NU-Horizonsat/RT1050-Board/RT1050.step

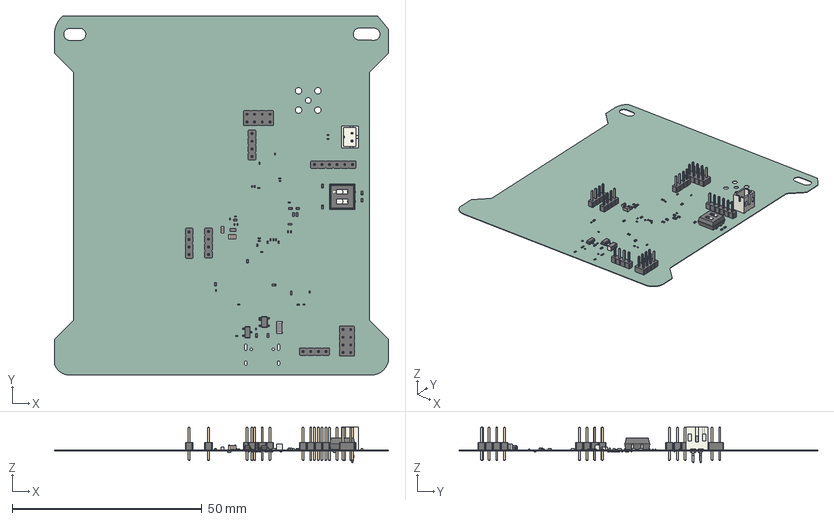
[picture p1: CAD file, 2025-01-03]
RT1050.step
88.0 x 94.5 x 9.40 mm
C_0201_0603Metric x 58
R_0402_1005Metric x 18
PinHeader_1x04_P200mm_Vertical x 4
L_0603_1608Metric
SOT_23
SOT_143
C_0805_2012Metric
PinHeader_1x06_P200mm_Vertical
PinHeader_2x04_P200mm_Vertical x 2
C_0402_1005Metric x 2
JST_B2B_PH_K
SW_DIP_SPSTx02_Slide_67x664mm_W673mm_P254mm_LowProfile_JPin
L_1206_3216Metric
C_0603_1608Metric
RT1050_PCB
