NU-Horizonsat/RT1050-Board/RT1050.pdf

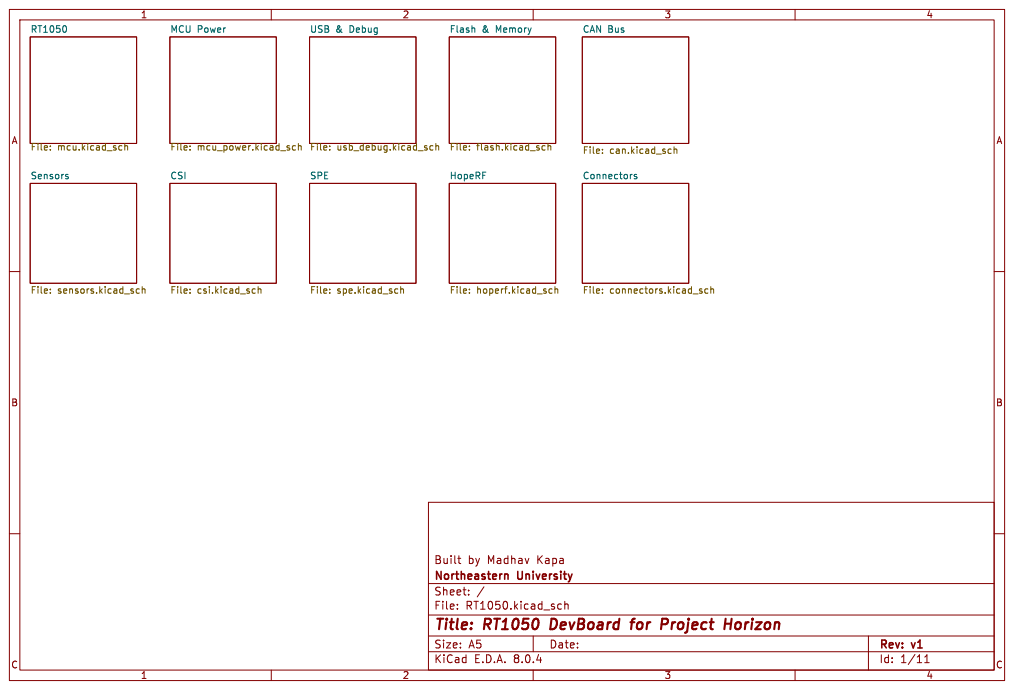
[picture p2: page 1]

Id: 1/11 Title: RT1050 DevBoard for Project Horizon

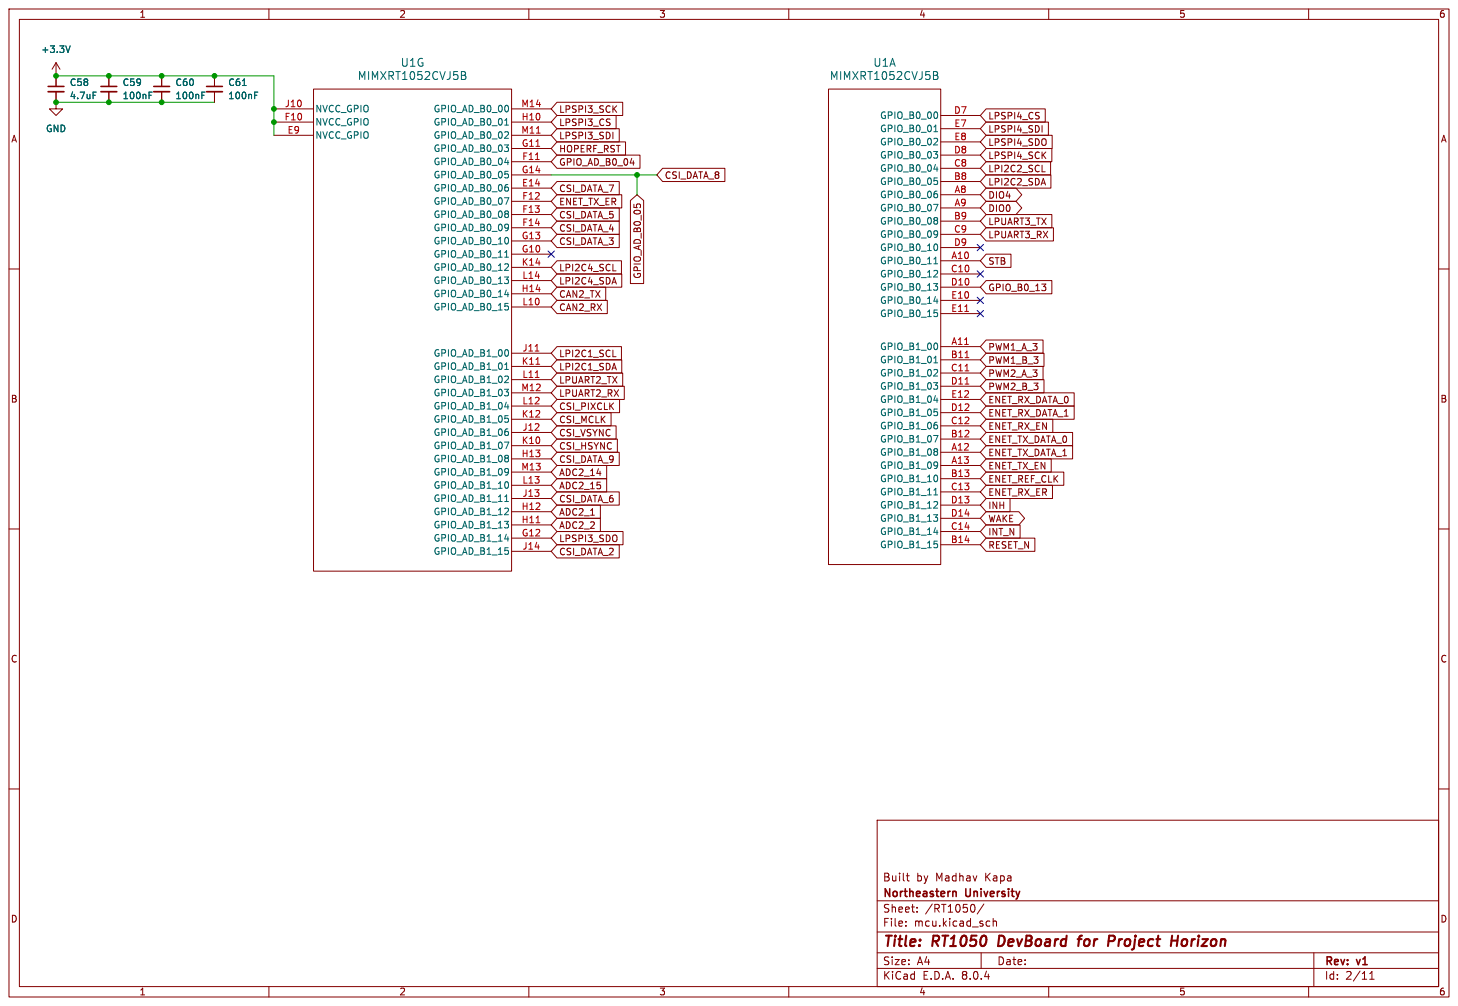
[picture p3: page 2]

Id: 2/11 Title: RT1050 DevBoard for Project Horizon

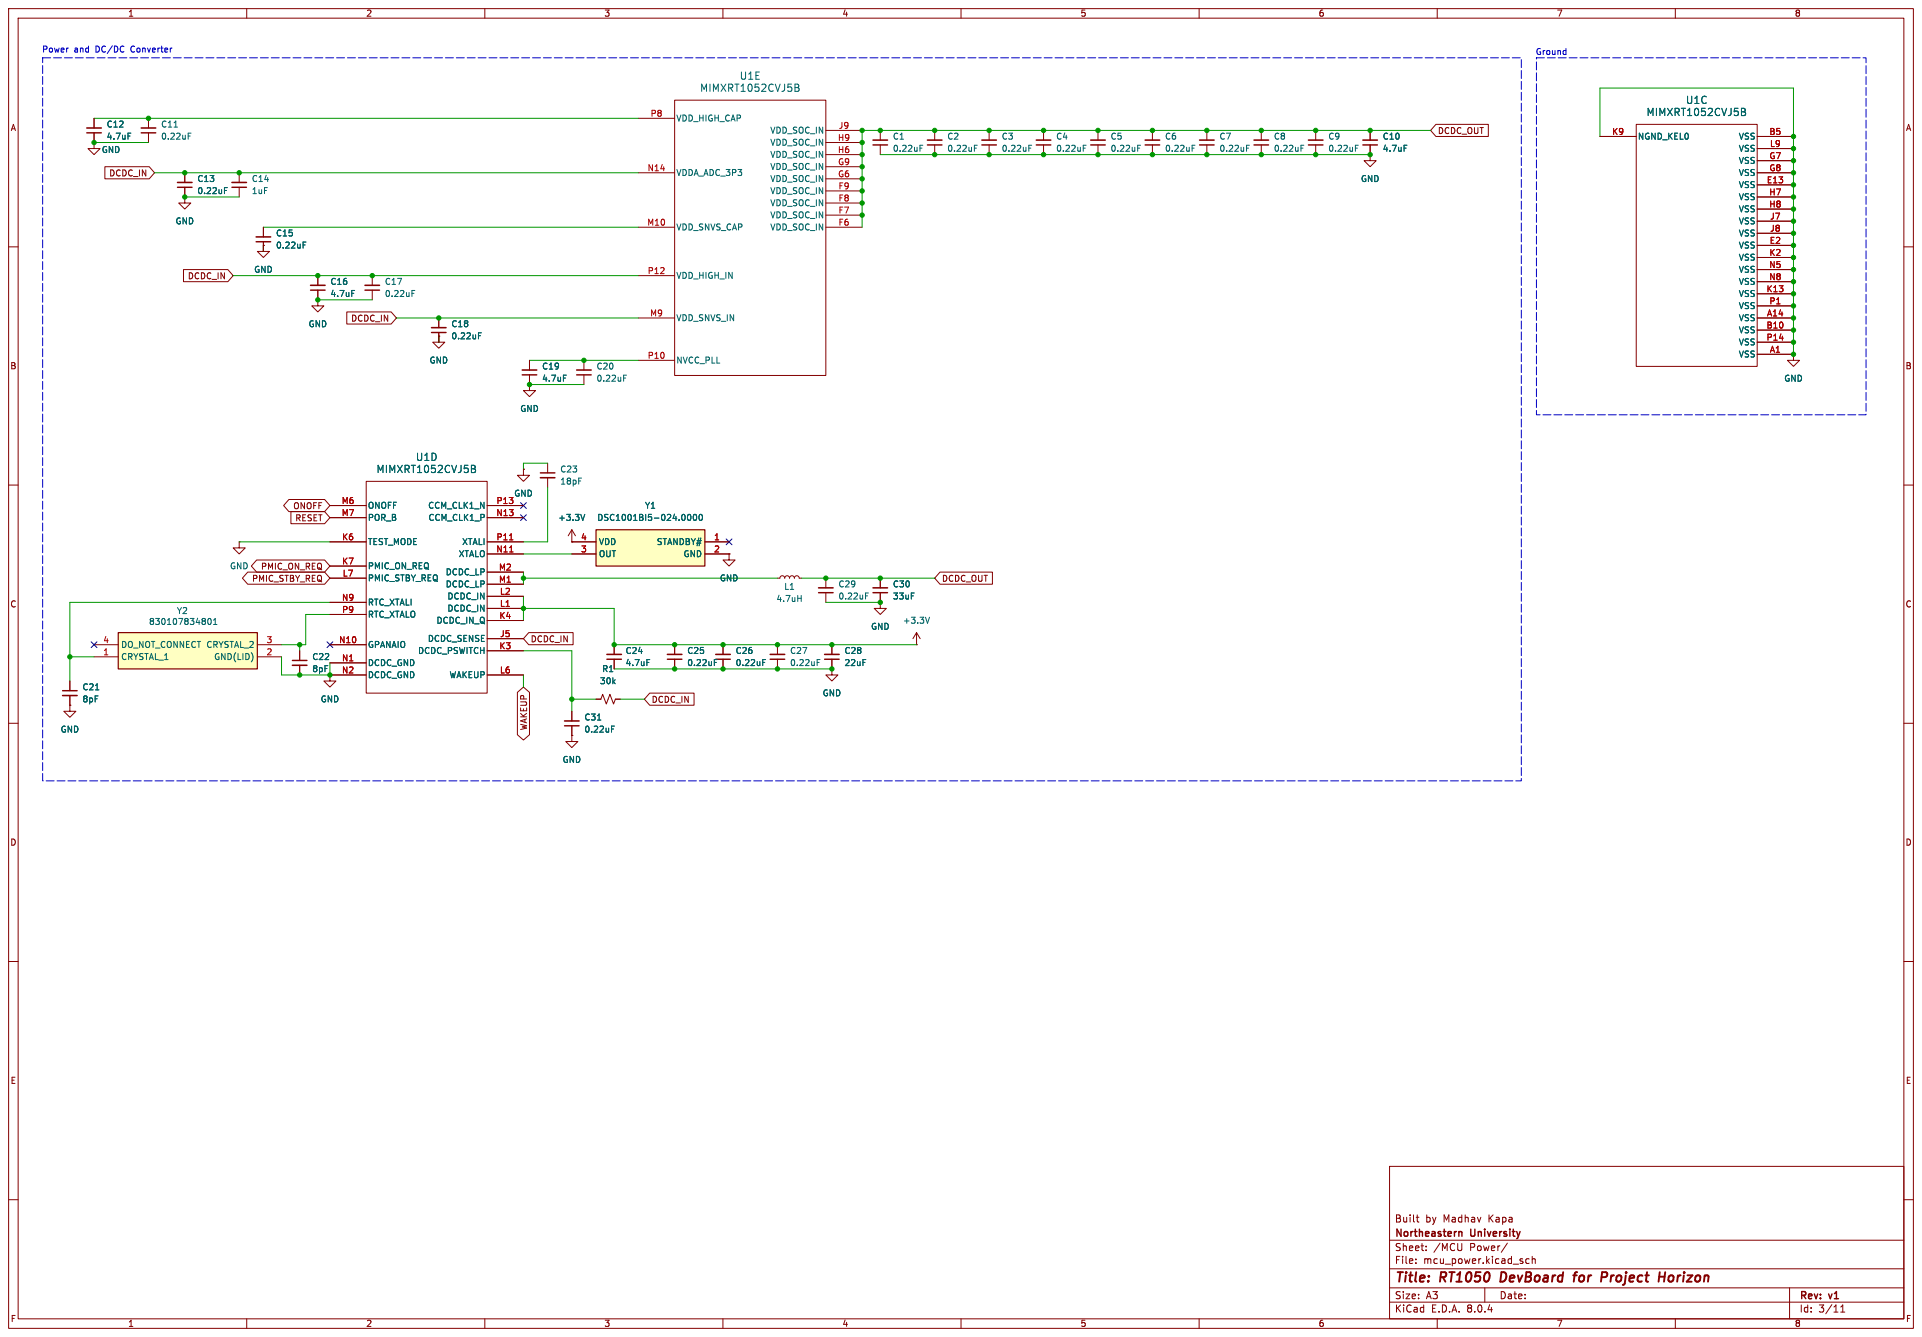
[picture p4: page 3]

Id: 3/11 Title: RT1050 DevBoard for Project Horizon

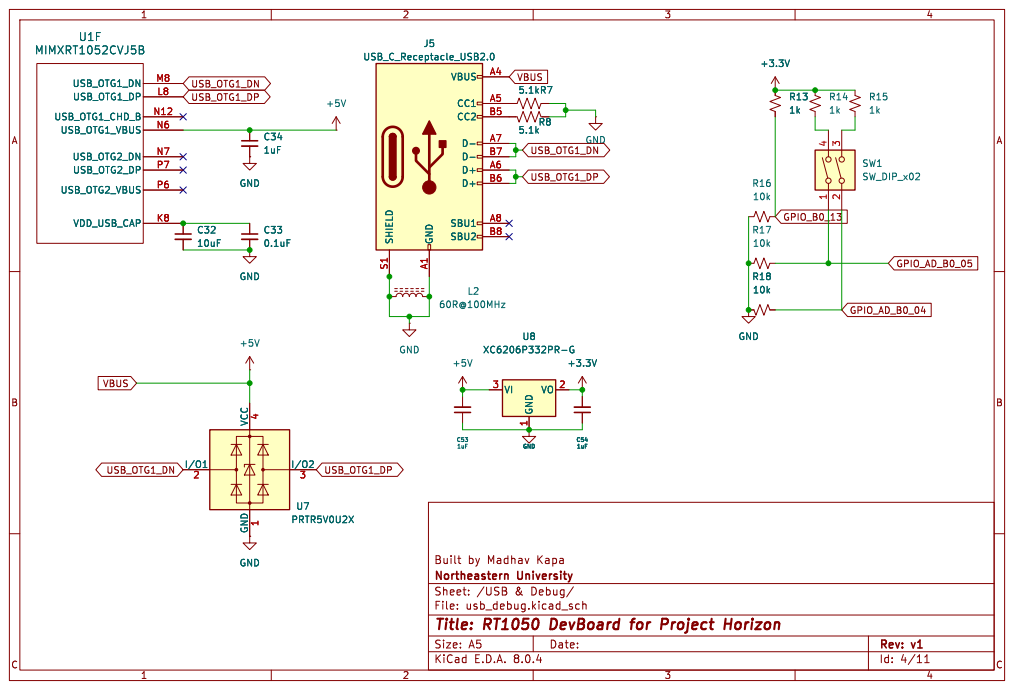
[picture p5: page 4]

Id: 4/11 Title: RT1050 DevBoard for Project Horizon

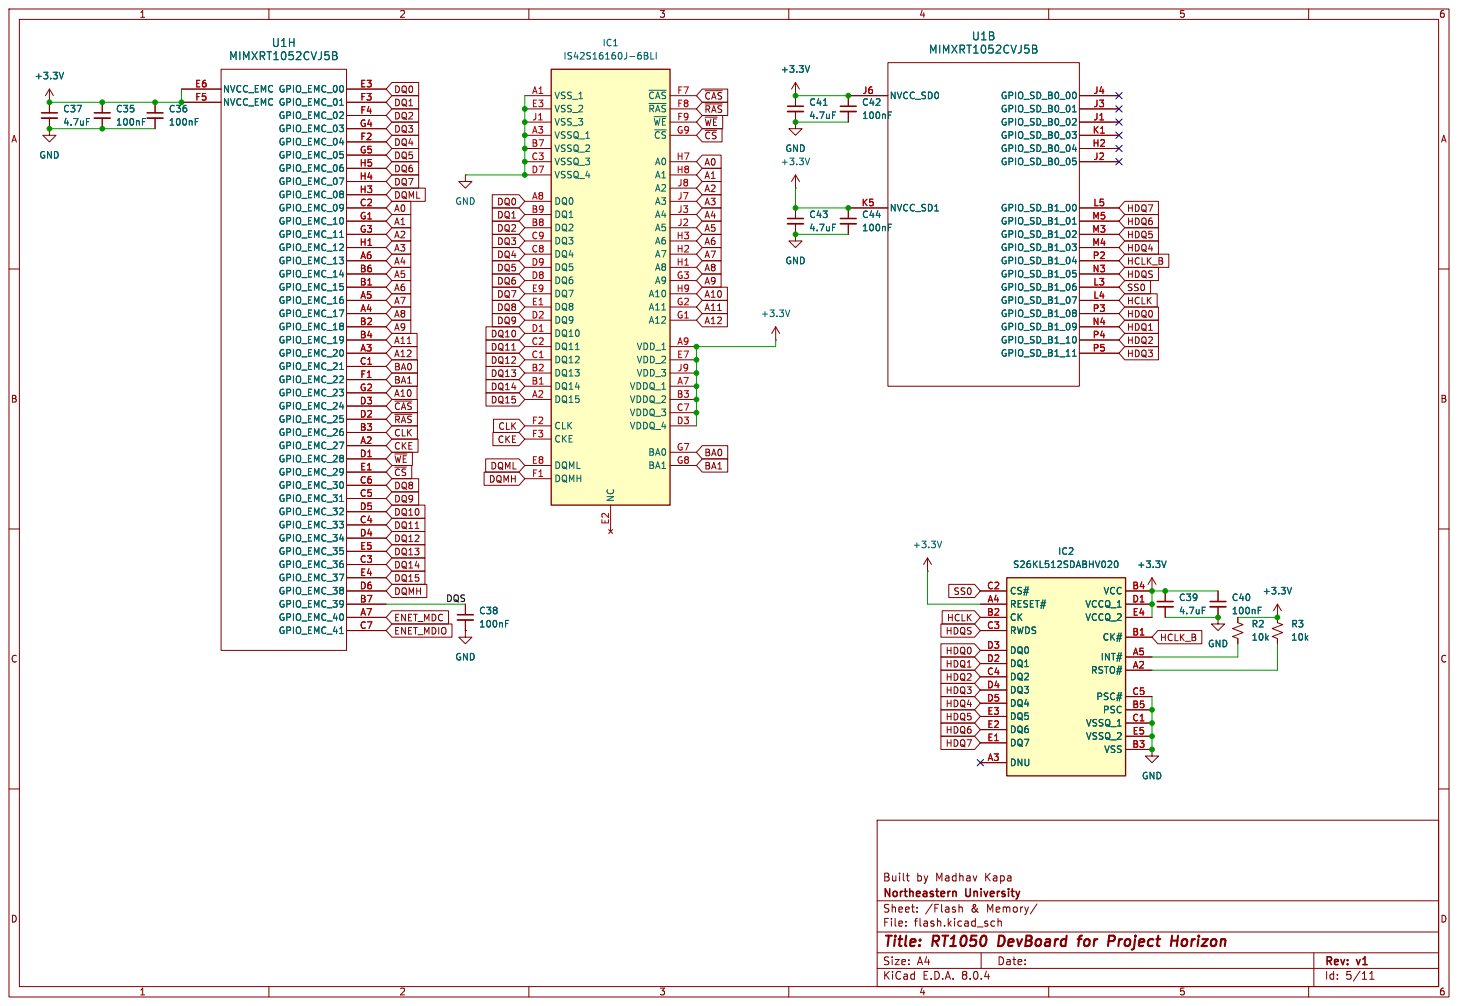
[picture p6: page 5]

Id: 5/11 Title: RT1050 DevBoard for Project Horizon

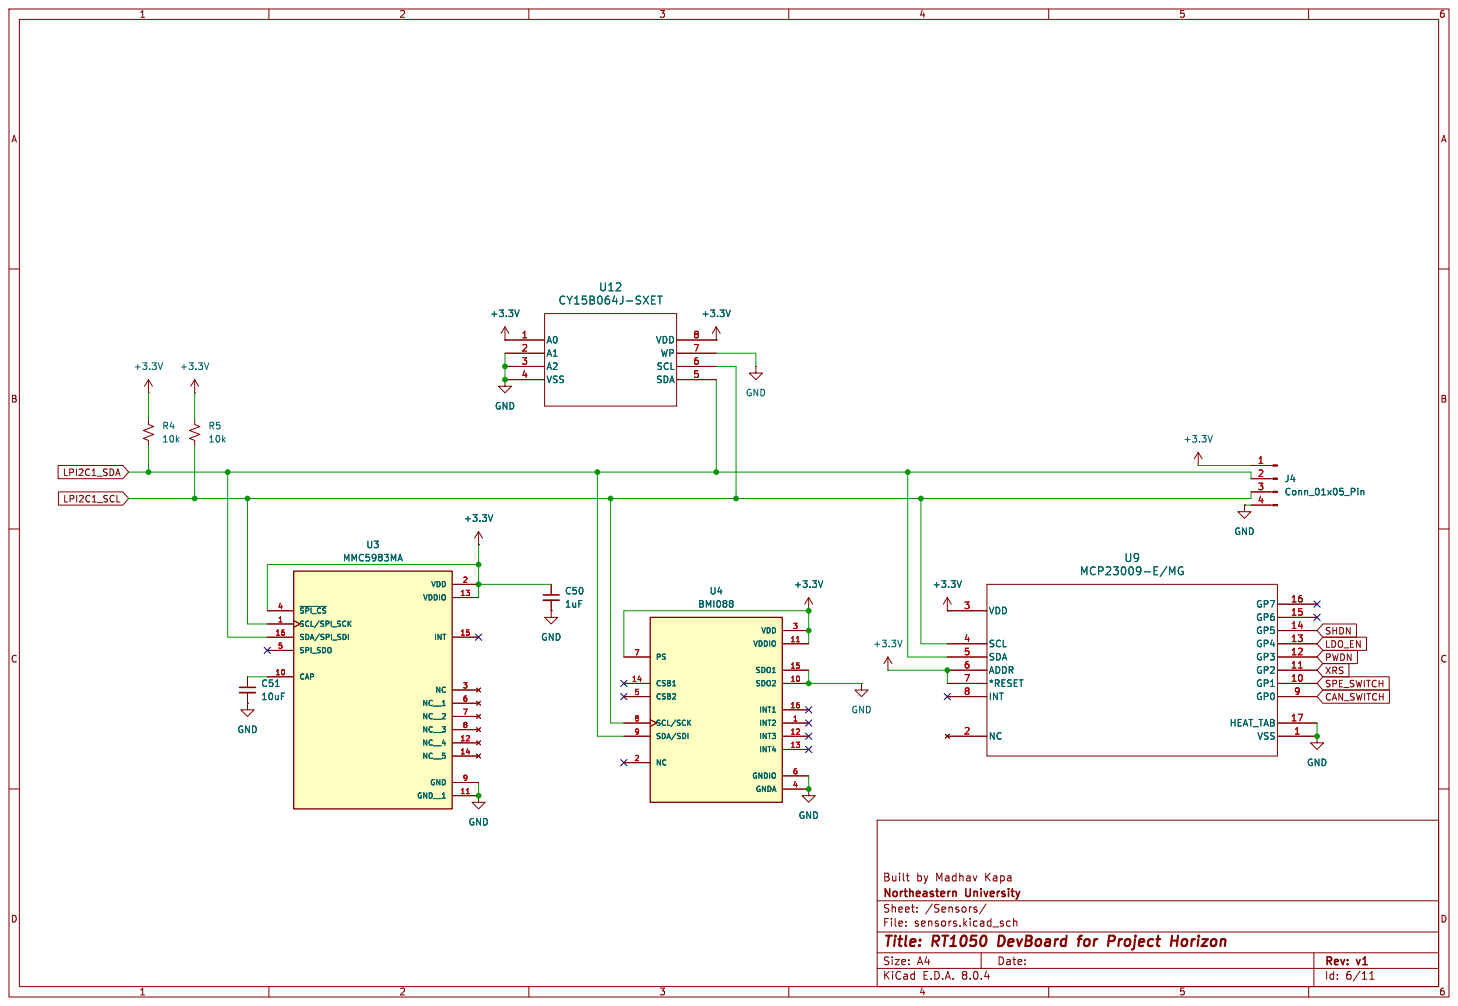
[picture p7: page 6]

Id: 6/11 Title: RT1050 DevBoard for Project Horizon

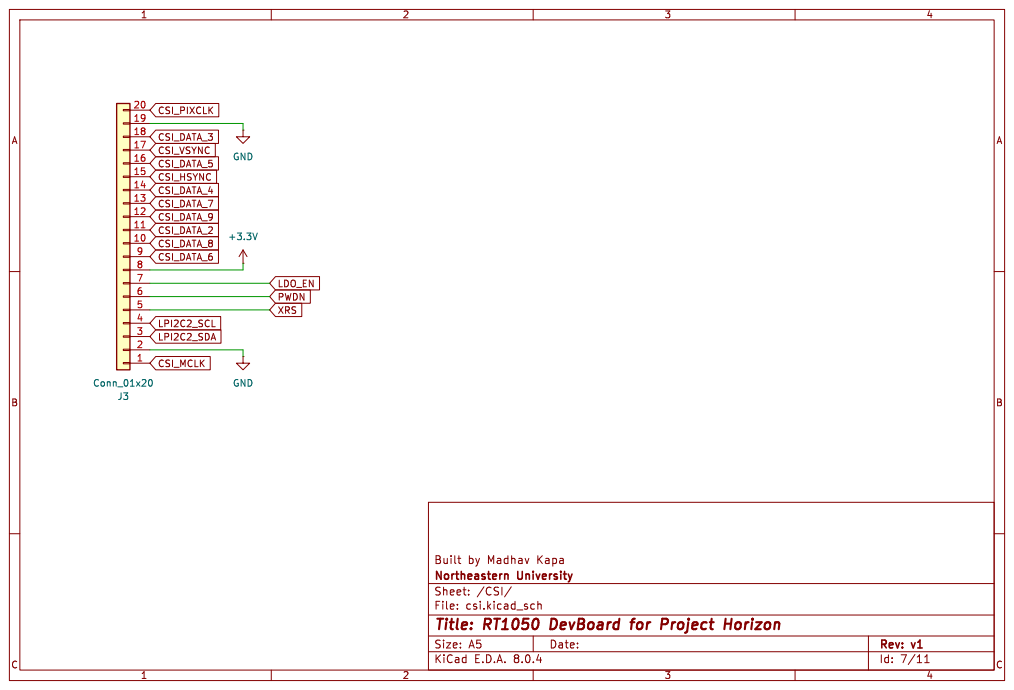
[picture p8: page 7]

Id: 7/11 Title: RT1050 DevBoard for Project Horizon

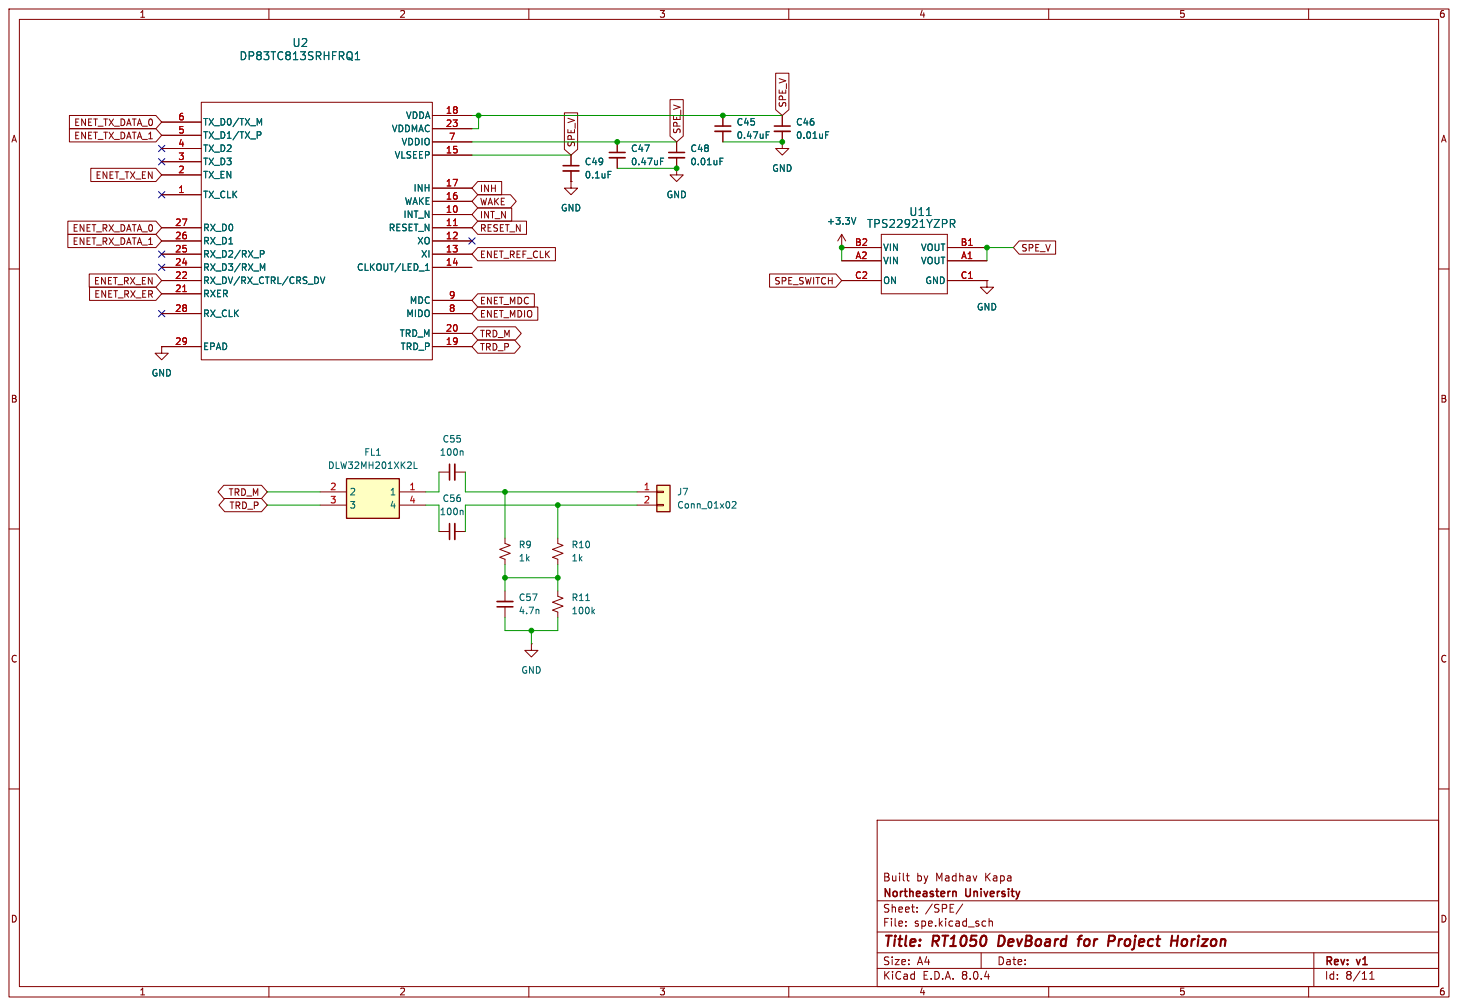
[picture p9: page 8]

Id: 8/11 Title: RT1050 DevBoard for Project Horizon

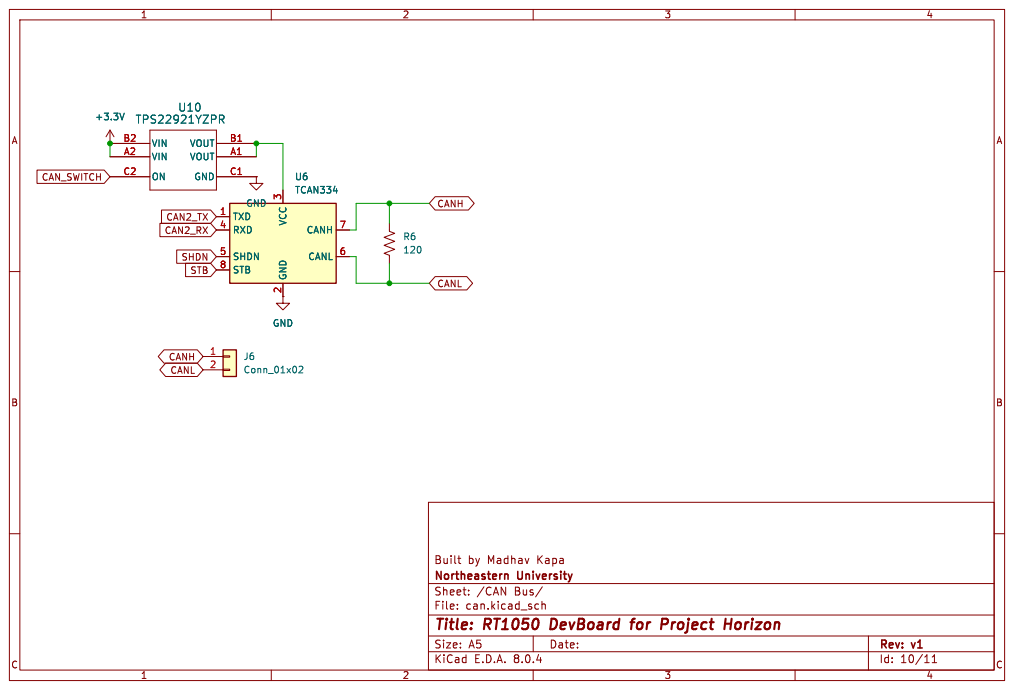
[picture p10: page 9]

3 RXD 4 SHDN 5 CANL 6 CANH 7 STB 8 GND U10 TPS22921YZPR

3 RXD 4 SHDN 5 CANL 6 CANH 7 STB 8 U6 TCAN334 R6

Id: 10/11 Title: RT1050 DevBoard for Project Horizon

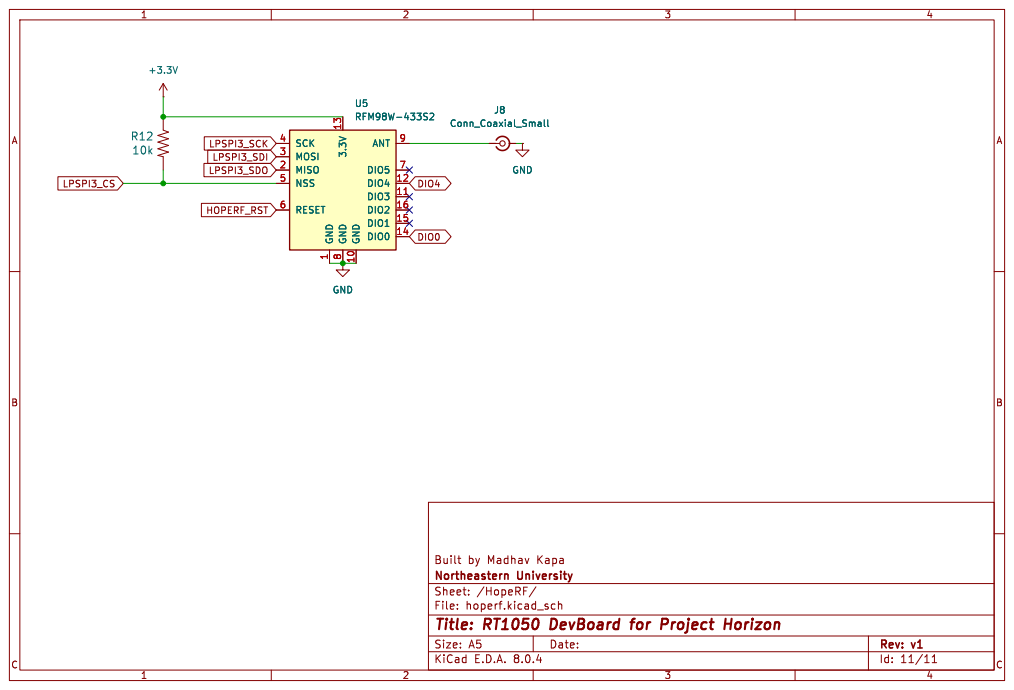
[picture p11: page 10]

1 GND 10 DIO3 11 DIO4 12 3.3V 13 DIO0 14 DIO1 15 DIO2 16 MISO 2 MOSI 3 SCK 4 NSS 5 RESET 6 DIO5 7 GND

Id: 11/11 Title: RT1050 DevBoard for Project Horizon

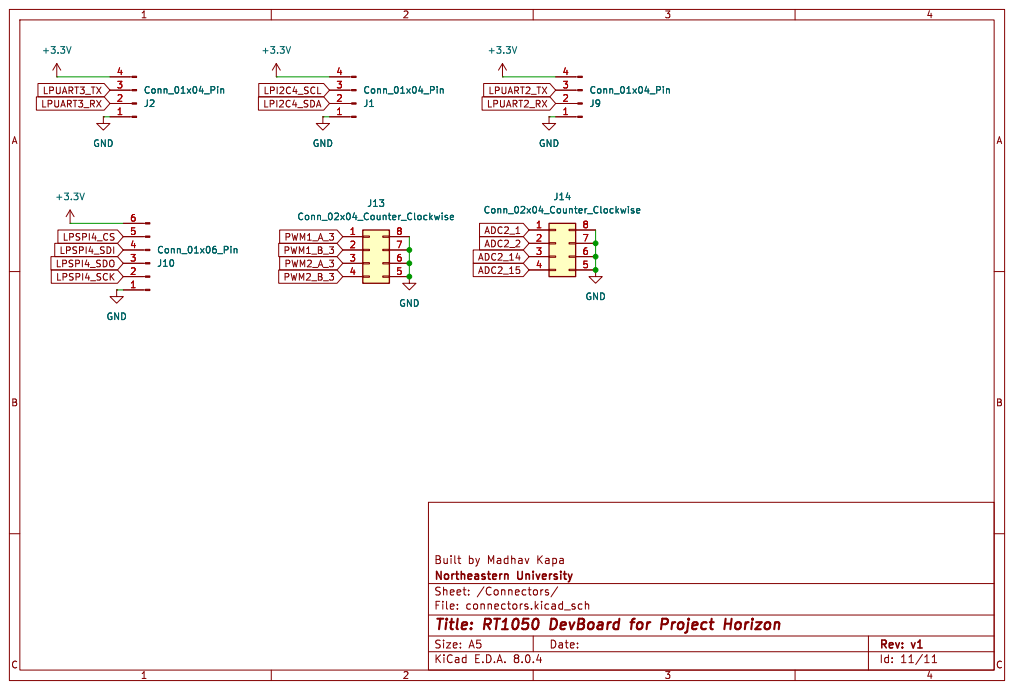
[picture p12: page 11]

Id: 11/11 Title: RT1050 DevBoard for Project Horizon
