NU-Horizonsat/RT1050-Board/RT1050.kicad_pcb

## KiCad design RT1050.kicad_pcb (2025-01-03)

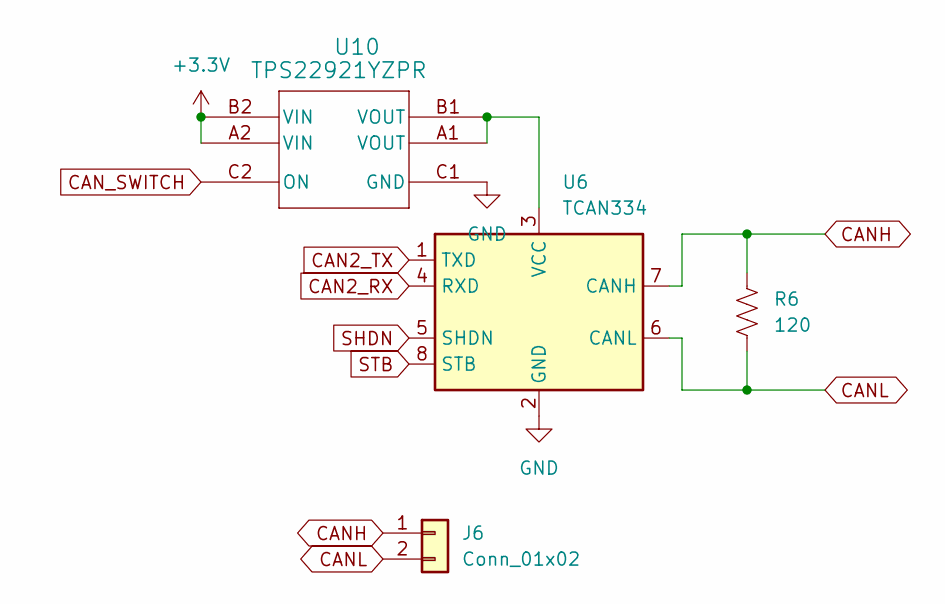
[picture p13: schematic can.kicad_sch, RT1050 DevBoard for Project Horizon]

Parts:
J6: Conn_01x02; JST_SH_BM02B-SRSS-TB_1x02-1MP_P1.00mm_Vertical
R6: 120; R_0402_1005Metric
U6: TCAN334; DCN0008A_M
U10: TPS22921YZPR; YZP6

Connections:
+3.3V: U10.A2 (VIN), U10.B2 (VIN); also elsewhere on the board
CAN2_RX: U6.4 (RXD); also elsewhere on the board
CAN2_TX: U6.1 (TXD); also elsewhere on the board
CANH: J6.1, R6.1, U6.7 (CANH)
CANL: J6.2, R6.2, U6.6 (CANL)
CAN_SWITCH: U10.C2 (ON); also elsewhere on the board
GND: U6.2 (GND), U10.C1 (GND); also elsewhere on the board
unnamed: U6.3 (VCC), U10.A1 (VOUT), U10.B1 (VOUT)
SHDN: U6.5 (SHDN); also elsewhere on the board
STB: U6.8 (STB); also elsewhere on the board

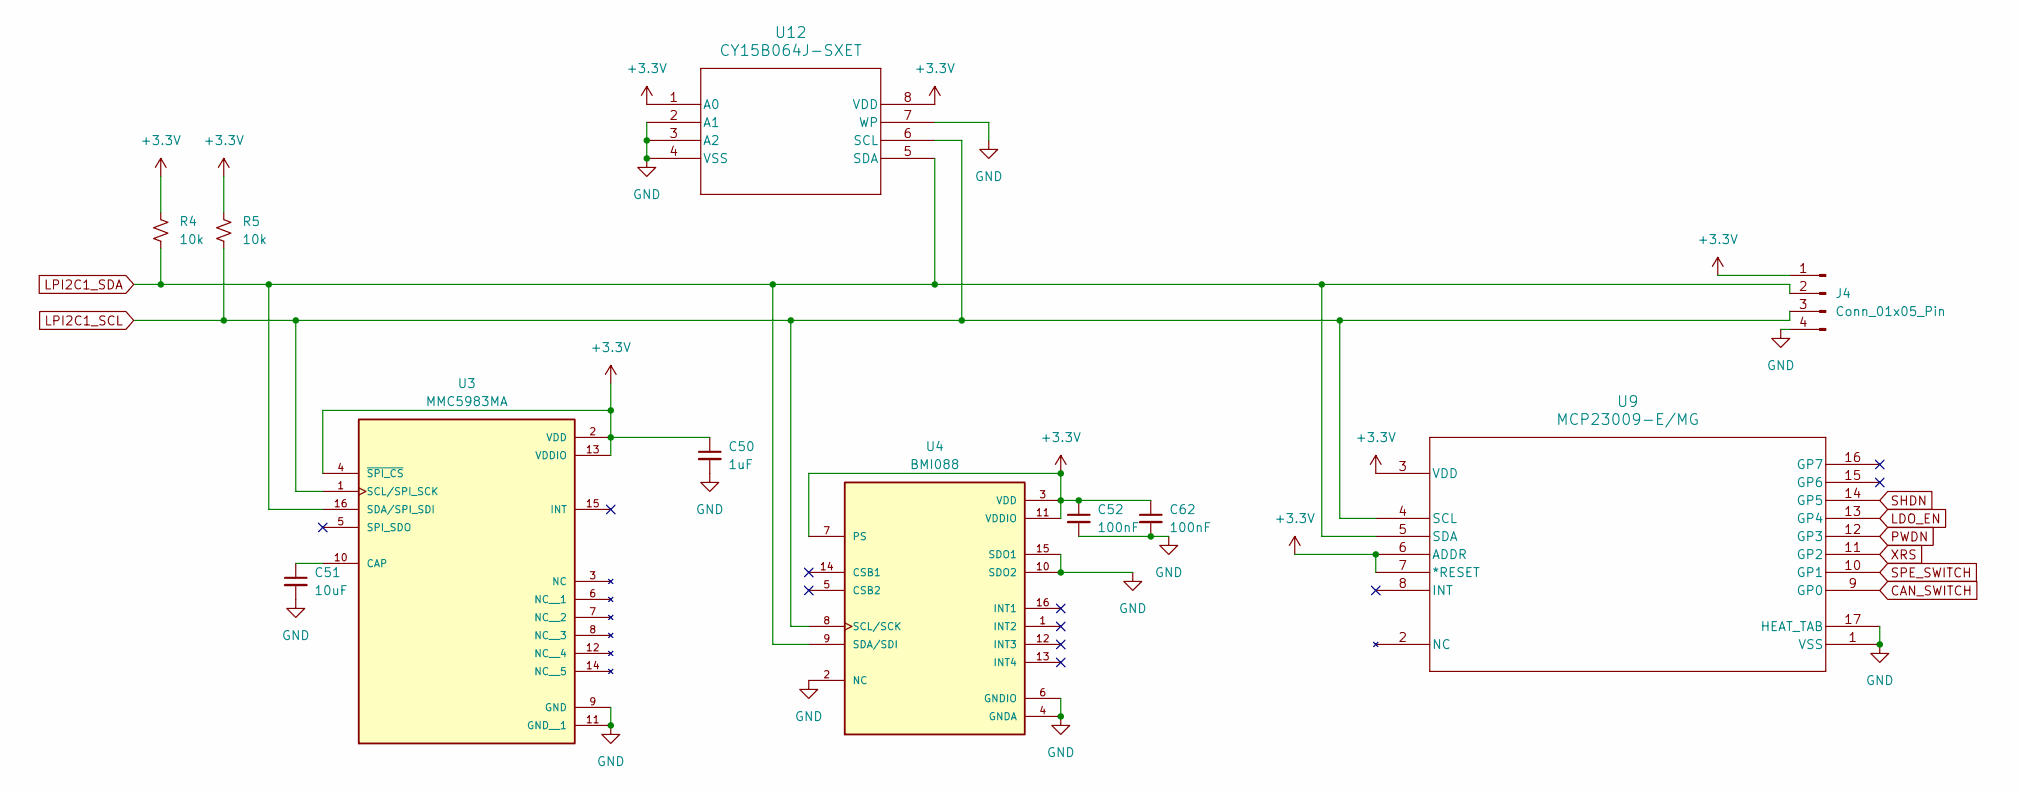
[picture p14: schematic sensors.kicad_sch, RT1050 DevBoard for Project Horizon]

Parts:
C50: 1uF; C_0201_0603Metric
C51: 10uF; C_0402_1005Metric
C52, C62: 100nF; C_0201_0603Metric
J4: Conn_01x05_Pin; PinHeader_1x04_P2.00mm_Vertical
R4, R5: 10k; R_0402_1005Metric
U3: MMC5983MA; MMC5983MA_MEM; PARTREV A
U4: BMI088; QFN_BMI085_BOS
U9: MCP23009-E/MG; QFN16_3x3MC_MCH
U12: CY15B064J-SXET; SO8_CY15_CYP

Connections:
+3.3V: C50.1, C52.1, C62.1, J4.1, R4.1, R5.1, U3.2 (VDD), U3.4 (~SPI_CS), U3.13 (VDDIO), U4.3 (VDD), U4.7 (PS), U4.11 (VDDIO), U9.3 (VDD), U9.6 (ADDR), U9.7 (*RESET), U12.1 (A0), U12.8 (VDD); also elsewhere on the board
CAN_SWITCH: U9.9 (GP0); also elsewhere on the board
GND: C50.2, C51.2, C52.2, C62.2, J4.4, U3.9 (GND), U3.11 (GND__1), U4.2 (NC), U4.4 (GNDA), U4.6 (GNDIO), U4.10 (SDO2), U4.15 (SDO1), U9.1 (VSS), U9.17 (HEAT_TAB), U12.2 (A1), U12.3 (A2), U12.4 (VSS), U12.7 (WP); also elsewhere on the board
LDO_EN: U9.13 (GP4); also elsewhere on the board
LPI2C1_SCL: J4.3, R5.2, U3.1 (SCL/SPI_SCK), U4.8 (SCL/SCK), U9.4 (SCL), U12.6 (SCL); also elsewhere on the board
LPI2C1_SDA: J4.2, R4.2, U3.16 (SDA/SPI_SDI), U4.9 (SDA/SDI), U9.5 (SDA), U12.5 (SDA); also elsewhere on the board
unnamed: C51.1, U3.10 (CAP)
PWDN: U9.12 (GP3); also elsewhere on the board
SHDN: U9.14 (GP5); also elsewhere on the board
SPE_SWITCH: U9.10 (GP1); also elsewhere on the board
XRS: U9.11 (GP2); also elsewhere on the board

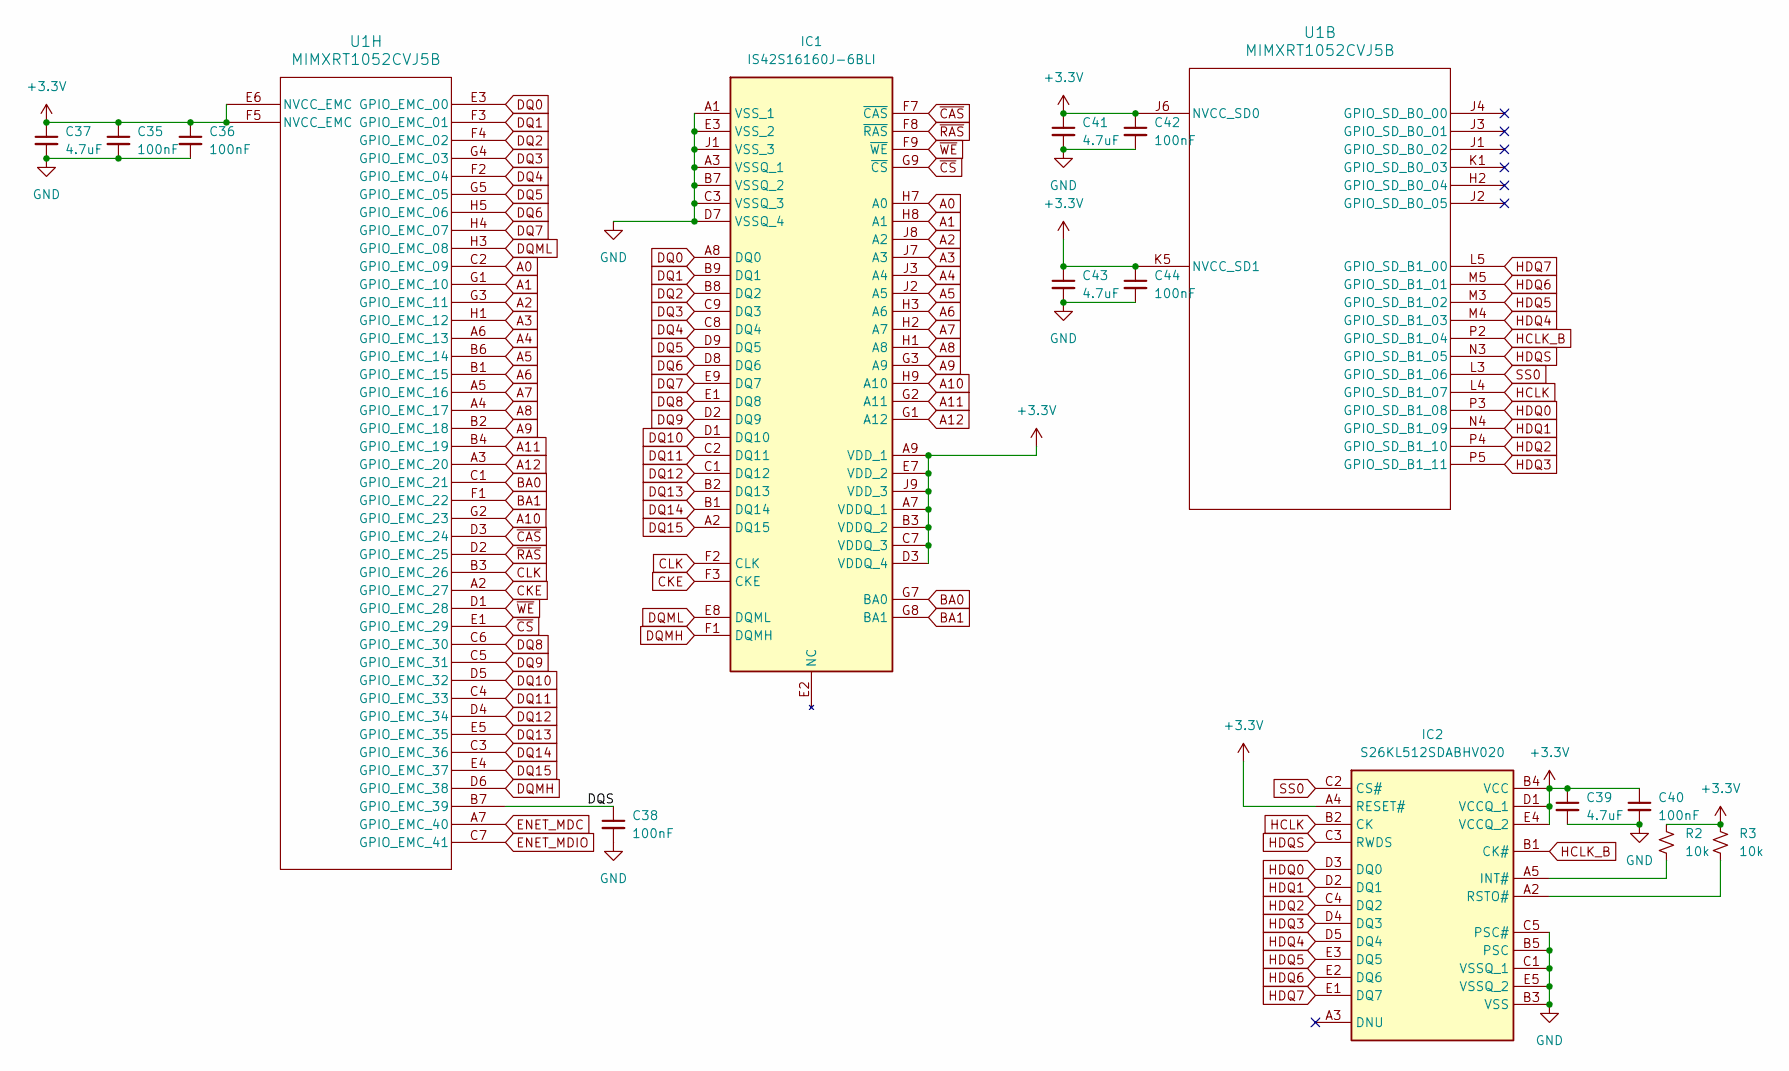
[picture p15: schematic flash.kicad_sch, RT1050 DevBoard for Project Horizon]

Parts:
C35, C36, C38, C40, C42, C44: 100nF; C_0201_0603Metric
C37, C39, C41, C43: 4.7uF; C_0201_0603Metric
IC1: IS42S16160J-6BLI; BGA54C80P9X9_800X800X120; Mouser Part Number 870-42S16160J6BLI
IC2: S26KL512SDABHV020; BGA24C100P5X5_600X800X100; Mouser Part Number 727-26KS512SDPBHV020
R2, R3: 10k; R_0402_1005Metric
U1: MIMXRT1052CVJ5B; MAPBGA196_12X12

Connections:
+3.3V: C35.1, C36.1, C37.1, C39.1, C40.1, C41.1, C42.1, C43.1, C44.1, IC1.A7 (VDDQ_1), IC1.A9 (VDD_1), IC1.B3 (VDDQ_2), IC1.C7 (VDDQ_3), IC1.D3 (VDDQ_4), IC1.E7 (VDD_2), IC1.J9 (VDD_3), IC2.A4 (RESET#), IC2.B4 (VCC), IC2.D1 (VCCQ_1), IC2.E4 (VCCQ_2), R2.1, R3.1, U1.E6 (NVCC_EMC), U1.F5 (NVCC_EMC), U1.J6 (NVCC_SD0), U1.K5 (NVCC_SD1); also elsewhere on the board
/Flash & Memory/DQS: C38.1, U1.B7 (GPIO_EMC_39)
A0: IC1.H7 (A0), U1.C2 (GPIO_EMC_09)
A1: IC1.H8 (A1), U1.G1 (GPIO_EMC_10)
A2: IC1.J8 (A2), U1.G3 (GPIO_EMC_11)
A3: IC1.J7 (A3), U1.H1 (GPIO_EMC_12)
A4: IC1.J3 (A4), U1.A6 (GPIO_EMC_13)
A5: IC1.J2 (A5), U1.B6 (GPIO_EMC_14)
A6: IC1.H3 (A6), U1.B1 (GPIO_EMC_15)
A7: IC1.H2 (A7), U1.A5 (GPIO_EMC_16)
A8: IC1.H1 (A8), U1.A4 (GPIO_EMC_17)
A9: IC1.G3 (A9), U1.B2 (GPIO_EMC_18)
A10: IC1.H9 (A10), U1.G2 (GPIO_EMC_23)
A11: IC1.G2 (A11), U1.B4 (GPIO_EMC_19)
A12: IC1.G1 (A12), U1.A3 (GPIO_EMC_20)
BA0: IC1.G7 (BA0), U1.C1 (GPIO_EMC_21)
BA1: IC1.G8 (BA1), U1.F1 (GPIO_EMC_22)
CKE: IC1.F3 (CKE), U1.A2 (GPIO_EMC_27)
CLK: IC1.F2 (CLK), U1.B3 (GPIO_EMC_26)
DQ0: IC1.A8 (DQ0), U1.E3 (GPIO_EMC_00)
DQ1: IC1.B9 (DQ1), U1.F3 (GPIO_EMC_01)
DQ2: IC1.B8 (DQ2), U1.F4 (GPIO_EMC_02)
DQ3: IC1.C9 (DQ3), U1.G4 (GPIO_EMC_03)
DQ4: IC1.C8 (DQ4), U1.F2 (GPIO_EMC_04)
DQ5: IC1.D9 (DQ5), U1.G5 (GPIO_EMC_05)
DQ6: IC1.D8 (DQ6), U1.H5 (GPIO_EMC_06)
DQ7: IC1.E9 (DQ7), U1.H4 (GPIO_EMC_07)
DQ8: IC1.E1 (DQ8), U1.C6 (GPIO_EMC_30)
DQ9: IC1.D2 (DQ9), U1.C5 (GPIO_EMC_31)
DQ10: IC1.D1 (DQ10), U1.D5 (GPIO_EMC_32)
DQ11: IC1.C2 (DQ11), U1.C4 (GPIO_EMC_33)
DQ12: IC1.C1 (DQ12), U1.D4 (GPIO_EMC_34)
DQ13: IC1.B2 (DQ13), U1.E5 (GPIO_EMC_35)
DQ14: IC1.B1 (DQ14), U1.C3 (GPIO_EMC_36)
DQ15: IC1.A2 (DQ15), U1.E4 (GPIO_EMC_37)
DQMH: IC1.F1 (DQMH), U1.D6 (GPIO_EMC_38)
DQML: IC1.E8 (DQML), U1.H3 (GPIO_EMC_08)
ENET_MDC: U1.A7 (GPIO_EMC_40); also elsewhere on the board
ENET_MDIO: U1.C7 (GPIO_EMC_41); also elsewhere on the board
GND: C35.2, C36.2, C37.2, C38.2, C39.2, C40.2, C41.2, C42.2, C43.2, C44.2, IC1.A1 (VSS_1), IC1.A3 (VSSQ_1), IC1.B7 (VSSQ_2), IC1.C3 (VSSQ_3), IC1.D7 (VSSQ_4), IC1.E3 (VSS_2), IC1.J1 (VSS_3), IC2.B3 (VSS), IC2.B5 (PSC), IC2.C1 (VSSQ_1), IC2.C5 (PSC#), IC2.E5 (VSSQ_2); also elsewhere on the board
HCLK: IC2.B2 (CK), U1.L4 (GPIO_SD_B1_07)
HCLK_B: IC2.B1 (CK#), U1.P2 (GPIO_SD_B1_04)
HDQ0: IC2.D3 (DQ0), U1.P3 (GPIO_SD_B1_08)
HDQ1: IC2.D2 (DQ1), U1.N4 (GPIO_SD_B1_09)
HDQ2: IC2.C4 (DQ2), U1.P4 (GPIO_SD_B1_10)
HDQ3: IC2.D4 (DQ3), U1.P5 (GPIO_SD_B1_11)
HDQ4: IC2.D5 (DQ4), U1.M4 (GPIO_SD_B1_03)
HDQ5: IC2.E3 (DQ5), U1.M3 (GPIO_SD_B1_02)
HDQ6: IC2.E2 (DQ6), U1.M5 (GPIO_SD_B1_01)
HDQ7: IC2.E1 (DQ7), U1.L5 (GPIO_SD_B1_00)
HDQS: IC2.C3 (RWDS), U1.N3 (GPIO_SD_B1_05)
unnamed: IC2.A5 (INT#), R2.2
unnamed: IC2.A2 (RSTO#), R3.2
SS0: IC2.C2 (CS#), U1.L3 (GPIO_SD_B1_06)
~CAS: IC1.F7 (~CAS), U1.D3 (GPIO_EMC_24)
~CS: IC1.G9 (~CS), U1.E1 (GPIO_EMC_29)
~RAS: IC1.F8 (~RAS), U1.D2 (GPIO_EMC_25)
~WE: IC1.F9 (~WE), U1.D1 (GPIO_EMC_28)

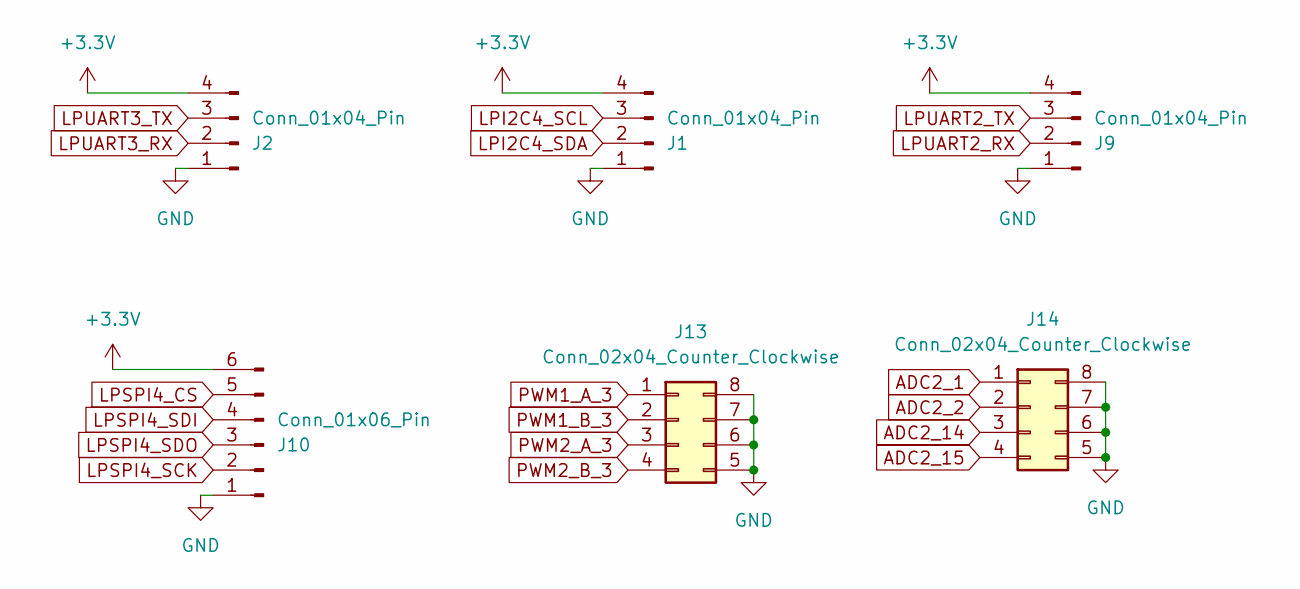
[picture p16: schematic connectors.kicad_sch, RT1050 DevBoard for Project Horizon]

Parts:
J1, J2, J9: Conn_01x04_Pin; PinHeader_1x04_P2.00mm_Vertical
J10: Conn_01x06_Pin; PinHeader_1x06_P2.00mm_Vertical
J13, J14: Conn_02x04_Counter_Clockwise; PinHeader_2x04_P2.00mm_Vertical

Connections:
+3.3V: J1.4, J2.4, J9.4, J10.6; also elsewhere on the board
ADC2_1: J14.1; also elsewhere on the board
ADC2_2: J14.2; also elsewhere on the board
ADC2_14: J14.3; also elsewhere on the board
ADC2_15: J14.4; also elsewhere on the board
GND: J1.1, J2.1, J9.1, J10.1, J13.5, J13.6, J13.7, J13.8, J14.5, J14.6, J14.7, J14.8; also elsewhere on the board
LPI2C4_SCL: J1.3; also elsewhere on the board
LPI2C4_SDA: J1.2; also elsewhere on the board
LPSPI4_CS: J10.5; also elsewhere on the board
LPSPI4_SCK: J10.2; also elsewhere on the board
LPSPI4_SDI: J10.4; also elsewhere on the board
LPSPI4_SDO: J10.3; also elsewhere on the board
LPUART2_RX: J9.2; also elsewhere on the board
LPUART2_TX: J9.3; also elsewhere on the board
LPUART3_RX: J2.2; also elsewhere on the board
LPUART3_TX: J2.3; also elsewhere on the board
PWM1_A_3: J13.1; also elsewhere on the board
PWM1_B_3: J13.2; also elsewhere on the board
PWM2_A_3: J13.3; also elsewhere on the board
PWM2_B_3: J13.4; also elsewhere on the board

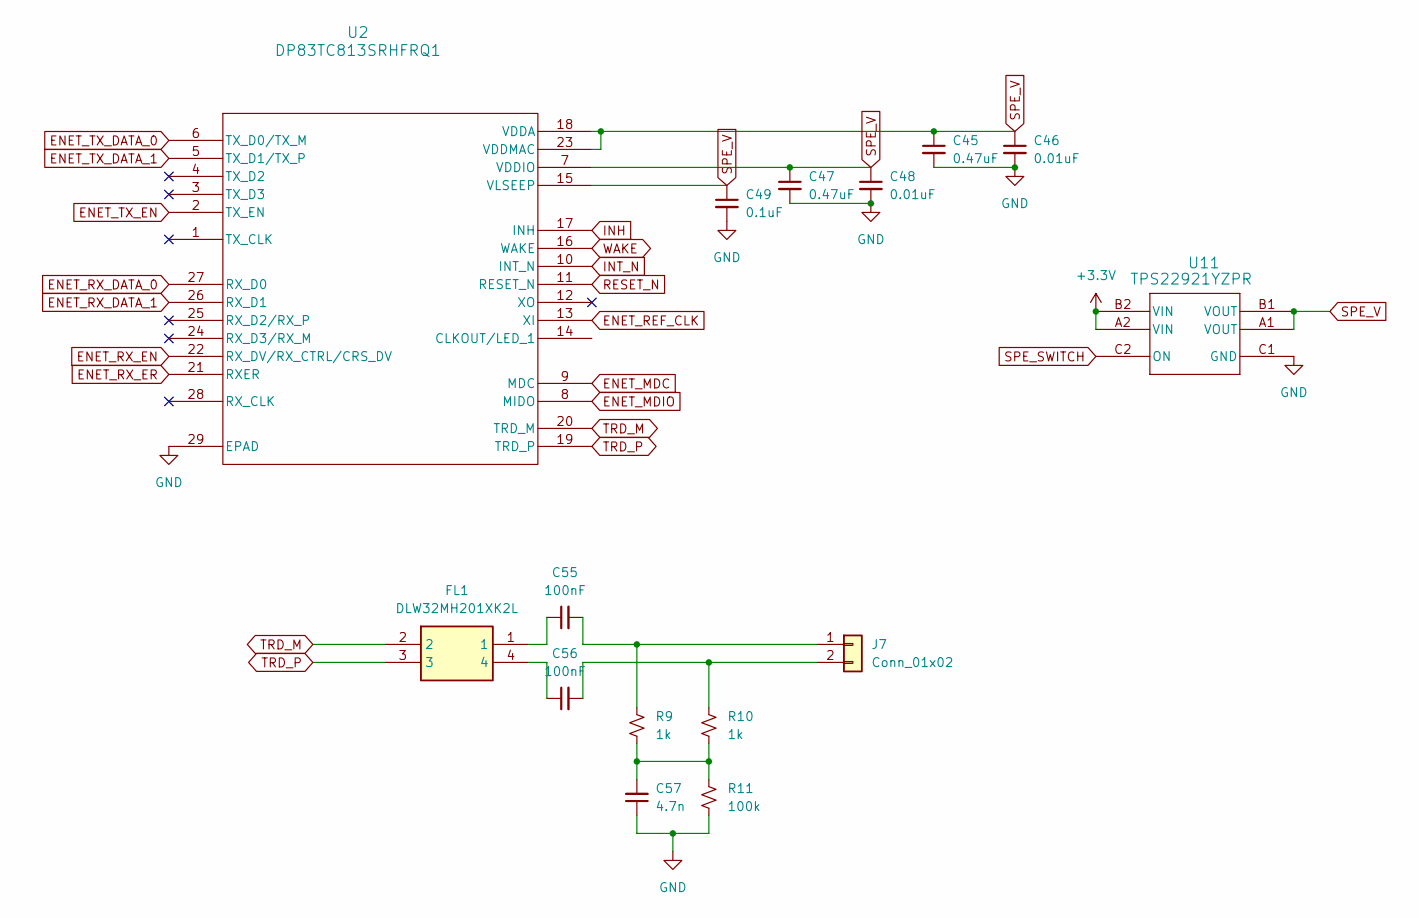
[picture p17: schematic spe.kicad_sch, RT1050 DevBoard for Project Horizon]

Parts:
C45, C47: 0.47uF; C_0201_0603Metric
C46, C48: 0.01uF; C_0201_0603Metric
C49: 0.1uF; C_0201_0603Metric
C55, C56: 100nF; C_0201_0603Metric
C57: 4.7n; C_0201_0603Metric
FL1: DLW32MH201XK2L; DLW32MH101XK2L; Mouser Part Number 81-DLW32MH201XK2L
J7: Conn_01x02; JST_PH_B2B-PH-K_1x02_P2.00mm_Vertical
R9, R10: 1k; R_0402_1005Metric
R11: 100k; R_0402_1005Metric
U2: DP83TC813SRHFRQ1; VQFN28_RHF_TEX
U11: TPS22921YZPR; YZP6

Connections:
+3.3V: U11.A2 (VIN), U11.B2 (VIN); also elsewhere on the board
ENET_MDC: U2.9 (MDC); also elsewhere on the board
ENET_MDIO: U2.8 (MIDO); also elsewhere on the board
ENET_REF_CLK: U2.13 (XI); also elsewhere on the board
ENET_RX_DATA_0: U2.27 (RX_D0); also elsewhere on the board
ENET_RX_DATA_1: U2.26 (RX_D1); also elsewhere on the board
ENET_RX_EN: U2.22 (RX_DV/RX_CTRL/CRS_DV); also elsewhere on the board
ENET_RX_ER: U2.21 (RXER); also elsewhere on the board
ENET_TX_DATA_0: U2.6 (TX_D0/TX_M); also elsewhere on the board
ENET_TX_DATA_1: U2.5 (TX_D1/TX_P); also elsewhere on the board
ENET_TX_EN: U2.2 (TX_EN); also elsewhere on the board
GND: C45.2, C46.2, C47.2, C48.2, C49.2, C57.1, R11.2, U2.29 (EPAD), U11.C1 (GND); also elsewhere on the board
INH: U2.17 (INH); also elsewhere on the board
INT_N: U2.10 (INT_N); also elsewhere on the board
unnamed: C55.1, FL1.1
unnamed: C56.1, FL1.4
unnamed: C57.2, R9.2, R10.2, R11.1
unnamed: C55.2, J7.1, R9.1
unnamed: C56.2, J7.2, R10.1
RESET_N: U2.11 (RESET_N); also elsewhere on the board
SPE_SWITCH: U11.C2 (ON); also elsewhere on the board
SPE_V: C45.1, C46.1, C47.1, C48.1, C49.1, U2.7 (VDDIO), U2.15 (VLSEEP), U2.18 (VDDA), U2.23 (VDDMAC), U11.A1 (VOUT), U11.B1 (VOUT)
TRD_M: FL1.2, U2.20 (TRD_M)
TRD_P: FL1.3, U2.19 (TRD_P)
WAKE: U2.16 (WAKE); also elsewhere on the board

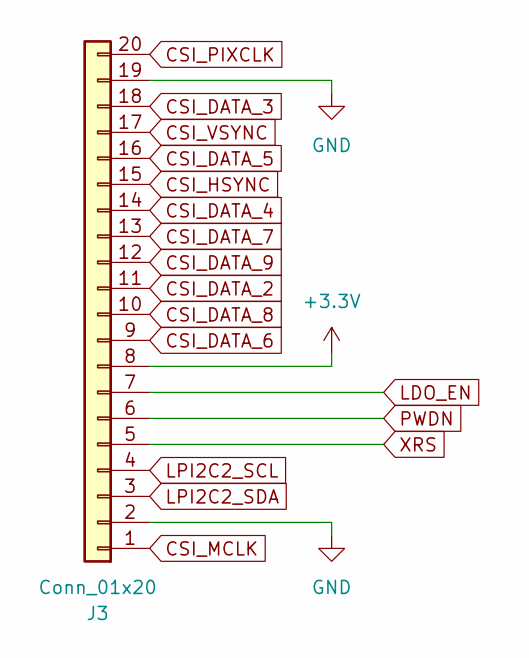
[picture p18: schematic csi.kicad_sch, RT1050 DevBoard for Project Horizon]

Parts:
J3: Conn_01x20; Molex_200528-0200_1x20-1MP_P1.00mm_Horizontal

Connections:
+3.3V: J3.8; also elsewhere on the board
CSI_DATA_2: J3.11; also elsewhere on the board
CSI_DATA_3: J3.18; also elsewhere on the board
CSI_DATA_4: J3.14; also elsewhere on the board
CSI_DATA_5: J3.16; also elsewhere on the board
CSI_DATA_6: J3.9; also elsewhere on the board
CSI_DATA_7: J3.13; also elsewhere on the board
CSI_DATA_8: J3.10; also elsewhere on the board
CSI_DATA_9: J3.12; also elsewhere on the board
CSI_HSYNC: J3.15; also elsewhere on the board
CSI_MCLK: J3.1; also elsewhere on the board
CSI_PIXCLK: J3.20; also elsewhere on the board
CSI_VSYNC: J3.17; also elsewhere on the board
GND: J3.2, J3.19; also elsewhere on the board
LDO_EN: J3.7; also elsewhere on the board
LPI2C2_SCL: J3.4; also elsewhere on the board
LPI2C2_SDA: J3.3; also elsewhere on the board
PWDN: J3.6; also elsewhere on the board
XRS: J3.5; also elsewhere on the board

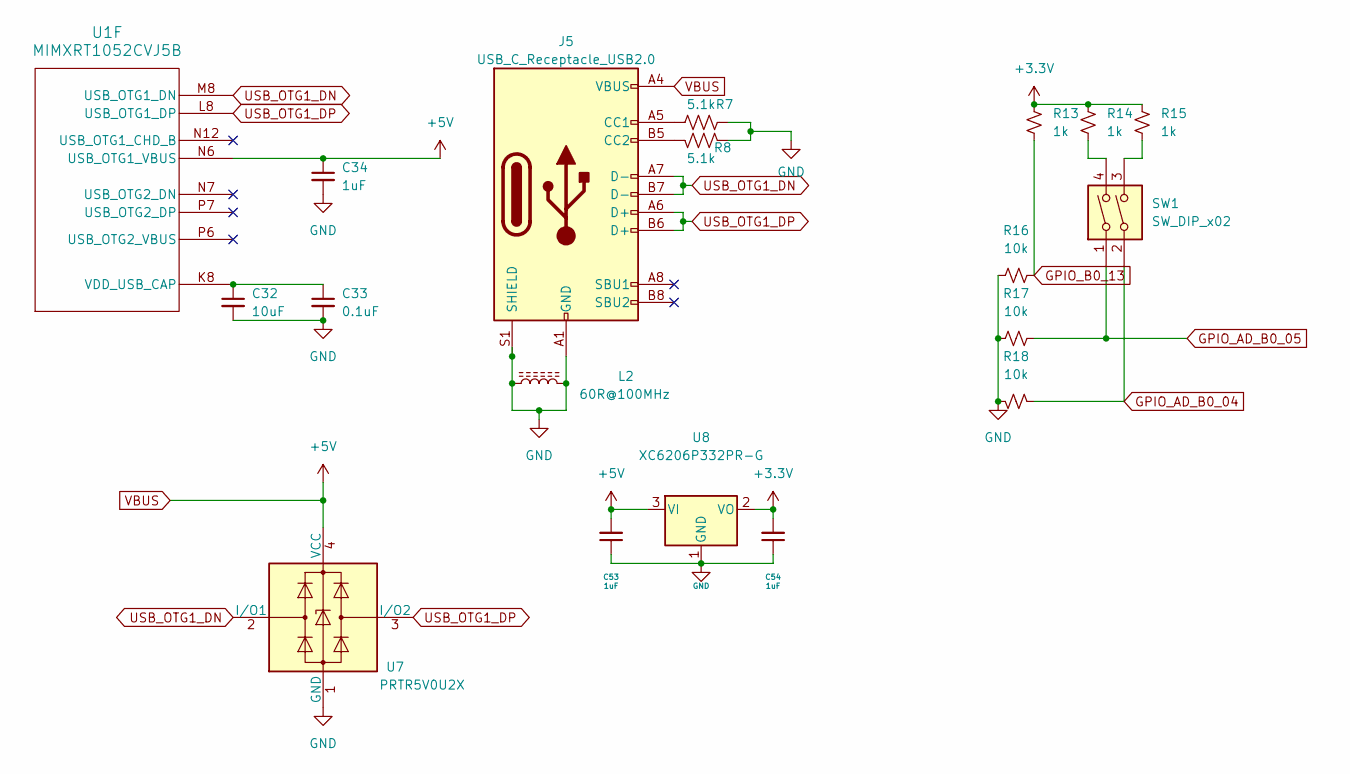
[picture p19: schematic usb_debug.kicad_sch, RT1050 DevBoard for Project Horizon]

Parts:
C32: 10uF; C_0402_1005Metric
C33: 0.1uF; C_0201_0603Metric
C34: 1uF; C_0201_0603Metric
C53, C54: 1uF; C_0201_0603Metric; LCSC C52923
J5: USB_C_Receptacle_USB2.0; USB_C_Receptacle_HRO_TYPE-C-31-M-12; JlcRotOffset 180
L2: 60R@100MHz; L_1206_3216Metric; Manufacturer Part No MLB3216-600P4A(f); LCSC C33600
R7, R8: 5.1k; R_0402_1005Metric
R13, R14, R15: 1k; R_0402_1005Metric
R16, R17, R18: 10k; R_0402_1005Metric
SW1: SW_DIP_x02; SW_DIP_SPSTx02_Slide_6.7x6.64mm_W6.73mm_P2.54mm_LowProfile_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
U1: MIMXRT1052CVJ5B; MAPBGA196_12X12
U7: PRTR5V0U2X; SOT-143; LCSC C2827688
U8: XC6206P332PR-G; SOT-23; LCSC C5446

Connections:
+3.3V: C54.2, R13.1, R14.1, R15.1, U8.2 (VO); also elsewhere on the board
CSI_DATA_8: R17.2, SW1.1; also elsewhere on the board
GND: C32.2, C33.2, C34.2, C53.1, C54.1, J5.A1 (GND), J5.A12 (GND), J5.B1 (GND), J5.B12 (GND), J5.S1 (SHIELD), L2.1, L2.2, R7.1, R8.1, R16.1, R17.1, R18.2, U7.1 (GND), U8.1 (GND); also elsewhere on the board
GPIO_AD_B0_04: R18.1, SW1.2; also elsewhere on the board
GPIO_B0_13: R13.2, R16.2; also elsewhere on the board
unnamed: J5.A5 (CC1), R7.2
unnamed: J5.B5 (CC2), R8.2
unnamed: R14.2, SW1.4
unnamed: R15.2, SW1.3
unnamed: C32.1, C33.1, U1.K8 (VDD_USB_CAP)
USB_OTG1_DN: J5.A7 (D-), J5.B7 (D-), U1.M8 (USB_OTG1_DN), U7.2 (I/O1)
USB_OTG1_DP: J5.A6 (D+), J5.B6 (D+), U1.L8 (USB_OTG1_DP), U7.3 (I/O2)
VBUS: C34.1, C53.2, J5.A4 (VBUS), J5.A9 (VBUS), J5.B4 (VBUS), J5.B9 (VBUS), U1.N6 (USB_OTG1_VBUS), U7.4 (VCC), U8.3 (VI)

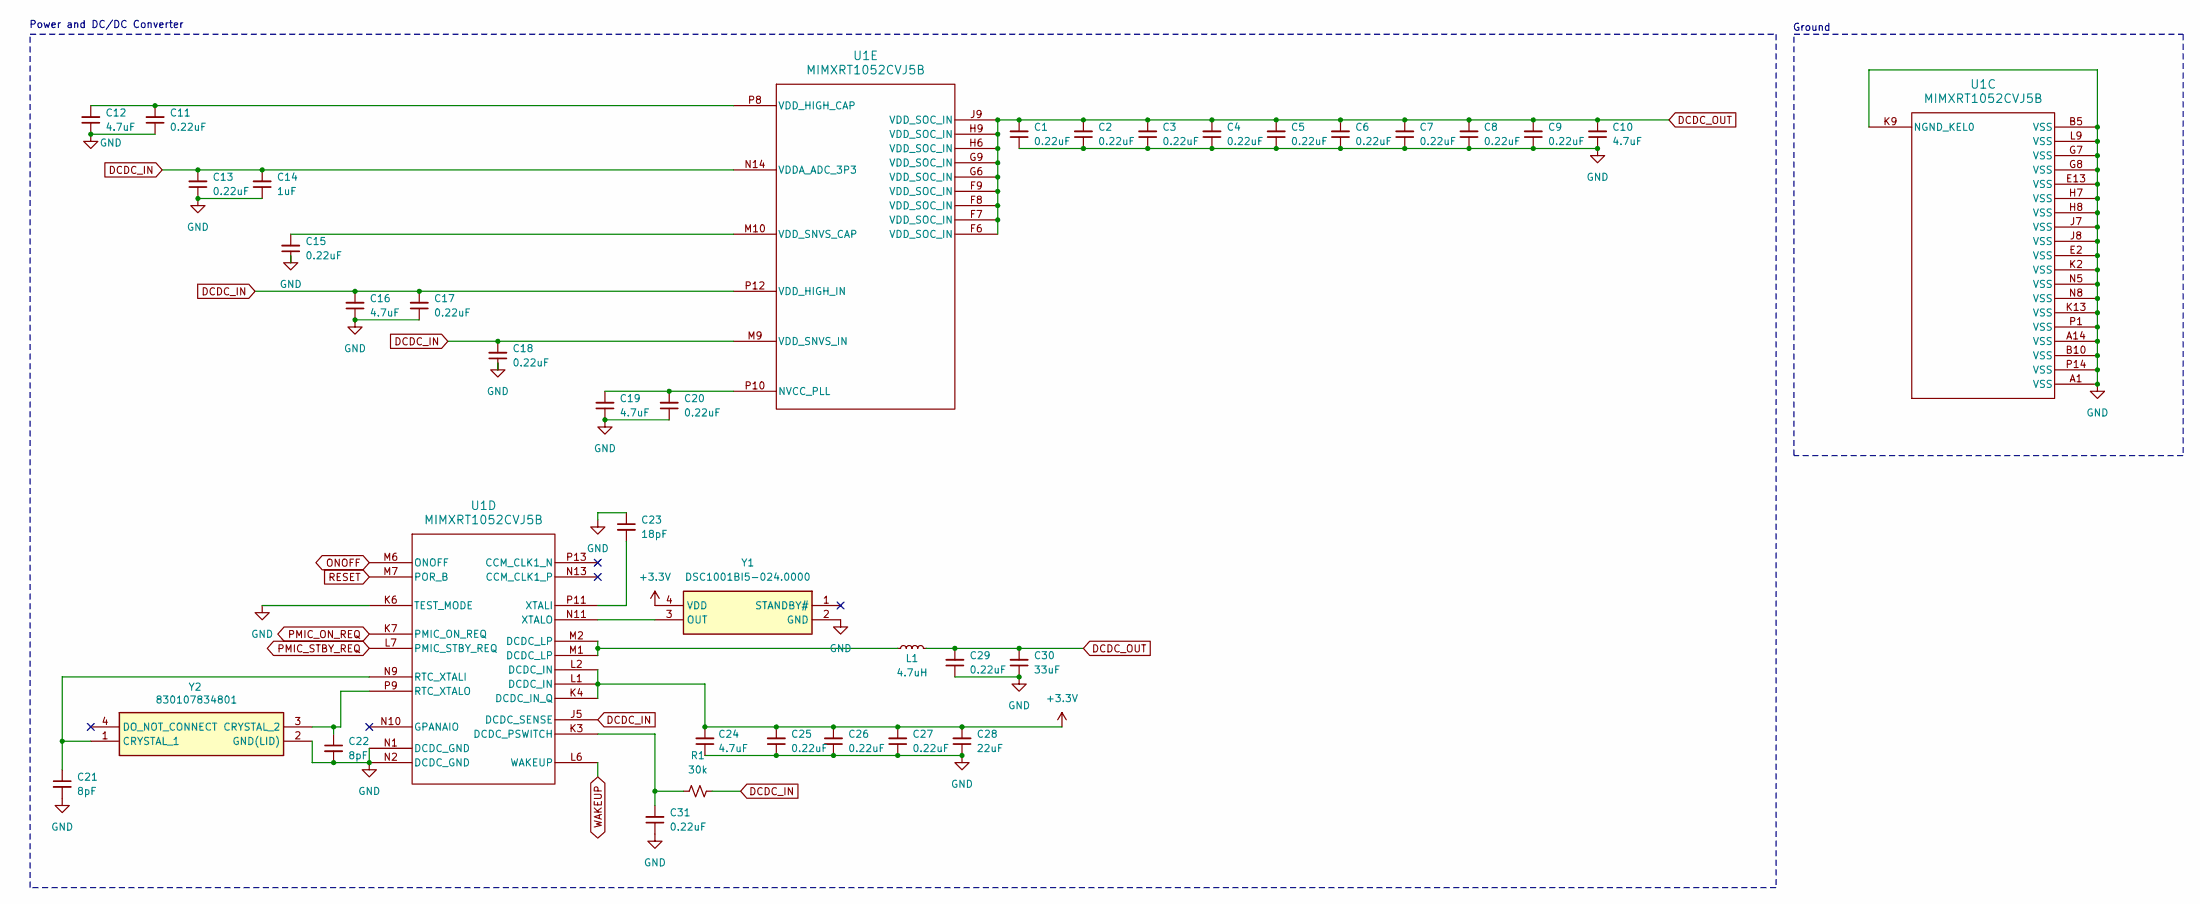
[picture p20: schematic mcu_power.kicad_sch, RT1050 DevBoard for Project Horizon]

Parts:
C1, C2, C3, C4, C5, C6, C7, C8, C9, C11, C13, C15, C17, C18, C20, C25, C26, C27, C29, C31: 0.22uF; C_0201_0603Metric
C10, C12, C16, C19, C24: 4.7uF; C_0201_0603Metric
C14: 1uF; C_0201_0603Metric
C21, C22: 8pF; C_0201_0603Metric
C23: 18pF; C_0201_0603Metric
C28: 22uF; C_0603_1608Metric
C30: 33uF; C_0805_2012Metric
L1: 4.7uH; L_0603_1608Metric
R1: 30k; R_0402_1005Metric
U1: MIMXRT1052CVJ5B; MAPBGA196_12X12
Y1: DSC1001BI5-024.0000; CDFN4_5X3P2_MCH; Mouser Part Number 579-001BI50240000
Y2: 830107834801; WE-XTAL_IQXC-146; Mouser Part Number 710-830107834801

Connections:
+3.3V: C24.2, C25.2, C26.2, C27.2, C28.2, U1.K4 (DCDC_IN_Q), U1.L1 (DCDC_IN), U1.L2 (DCDC_IN), Y1.4 (VDD); also elsewhere on the board
DCDC_IN: C13.2, C14.2, C16.2, C17.2, C18.2, R1.2, U1.J5 (DCDC_SENSE), U1.M9 (VDD_SNVS_IN), U1.N14 (VDDA_ADC_3P3), U1.P12 (VDD_HIGH_IN)
DCDC_OUT: C1.2, C2.2, C3.2, C4.2, C5.2, C6.2, C7.2, C8.2, C9.2, C10.2, C29.2, C30.2, L1.1, U1.F6 (VDD_SOC_IN), U1.F7 (VDD_SOC_IN), U1.F8 (VDD_SOC_IN), U1.F9 (VDD_SOC_IN), U1.G6 (VDD_SOC_IN), U1.G9 (VDD_SOC_IN), U1.H6 (VDD_SOC_IN), U1.H9 (VDD_SOC_IN), U1.J9 (VDD_SOC_IN)
GND: C1.1, C2.1, C3.1, C4.1, C5.1, C6.1, C7.1, C8.1, C9.1, C10.1, C11.1, C12.1, C13.1, C14.1, C15.1, C16.1, C17.1, C18.1, C19.1, C20.1, C21.2, C22.2, C23.1, C24.1, C25.1, C26.1, C27.1, C28.1, C29.1, C30.1, C31.1, U1.A1 (VSS), U1.A14 (VSS), U1.B5 (VSS), U1.B10 (VSS), U1.E2 (VSS), U1.E13 (VSS), U1.G7 (VSS), U1.G8 (VSS), U1.H7 (VSS), U1.H8 (VSS), U1.J7 (VSS), U1.J8 (VSS), U1.K2 (VSS), U1.K6 (TEST_MODE), U1.K9 (NGND_KEL0), U1.K13 (VSS), U1.L9 (VSS), U1.N1 (DCDC_GND), U1.N2 (DCDC_GND), U1.N5 (VSS), U1.N8 (VSS), U1.P1 (VSS), U1.P14 (VSS), Y1.2 (GND), Y2.2 (GND(LID)); also elsewhere on the board
unnamed: L1.2, U1.M1 (DCDC_LP), U1.M2 (DCDC_LP)
unnamed: C31.2, R1.1, U1.K3 (DCDC_PSWITCH)
unnamed: C21.1, U1.N9 (RTC_XTALI), Y2.1 (CRYSTAL_1)
unnamed: C22.1, U1.P9 (RTC_XTALO), Y2.3 (CRYSTAL_2)
unnamed: C23.2, U1.P11 (XTALI)
unnamed: U1.N11 (XTALO), Y1.3 (OUT)
unnamed: C19.2, C20.2, U1.P10 (NVCC_PLL)
unnamed: C11.2, C12.2, U1.P8 (VDD_HIGH_CAP)
unnamed: C15.2, U1.M10 (VDD_SNVS_CAP)
ONOFF: U1.M6 (ONOFF)
PMIC_ON_REQ: U1.K7 (PMIC_ON_REQ)
PMIC_STBY_REQ: U1.L7 (PMIC_STBY_REQ)
RESET: U1.M7 (POR_B)
WAKEUP: U1.L6 (WAKEUP)

Notes on the sheet:
Power and DC/DC Converter
Ground

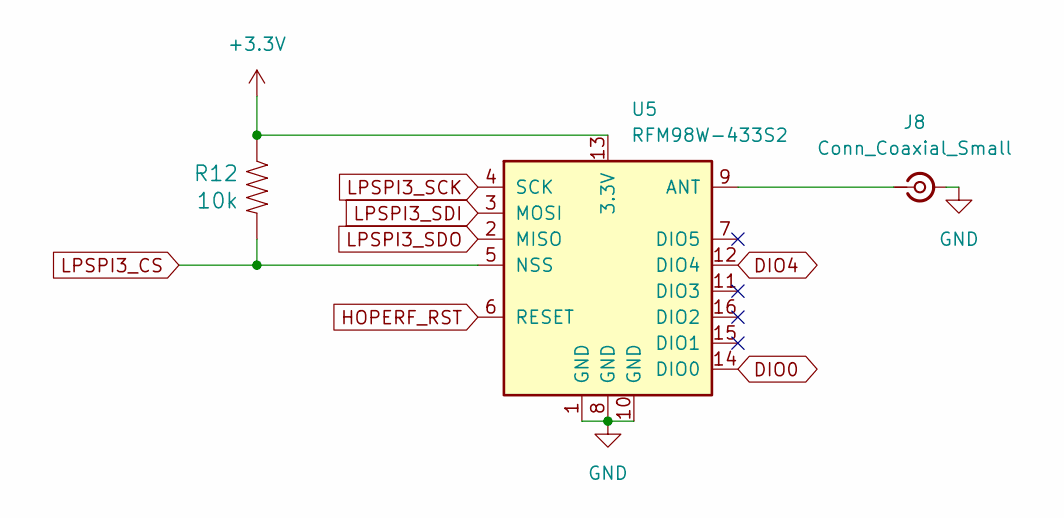
[picture p21: schematic hoperf.kicad_sch, RT1050 DevBoard for Project Horizon]

Parts:
J8: Conn_Coaxial_Small; SMA_Amphenol_132134_Vertical
R12: 10k; R_0402_1005Metric
U5: RFM98W-433S2; HOPERF_RFM95W_SMD

Connections:
+3.3V: R12.1, U5.13 (3.3V); also elsewhere on the board
DIO0: U5.14 (DIO0); also elsewhere on the board
DIO4: U5.12 (DIO4); also elsewhere on the board
GND: J8.2 (Ext), U5.1 (GND), U5.8 (GND), U5.10 (GND); also elsewhere on the board
HOPERF_RST: U5.6 (RESET); also elsewhere on the board
LPSPI3_CS: R12.2, U5.5 (NSS); also elsewhere on the board
LPSPI3_SCK: U5.4 (SCK); also elsewhere on the board
LPSPI3_SDI: U5.3 (MOSI); also elsewhere on the board
LPSPI3_SDO: U5.2 (MISO); also elsewhere on the board
unnamed: J8.1 (In), U5.9 (ANT)

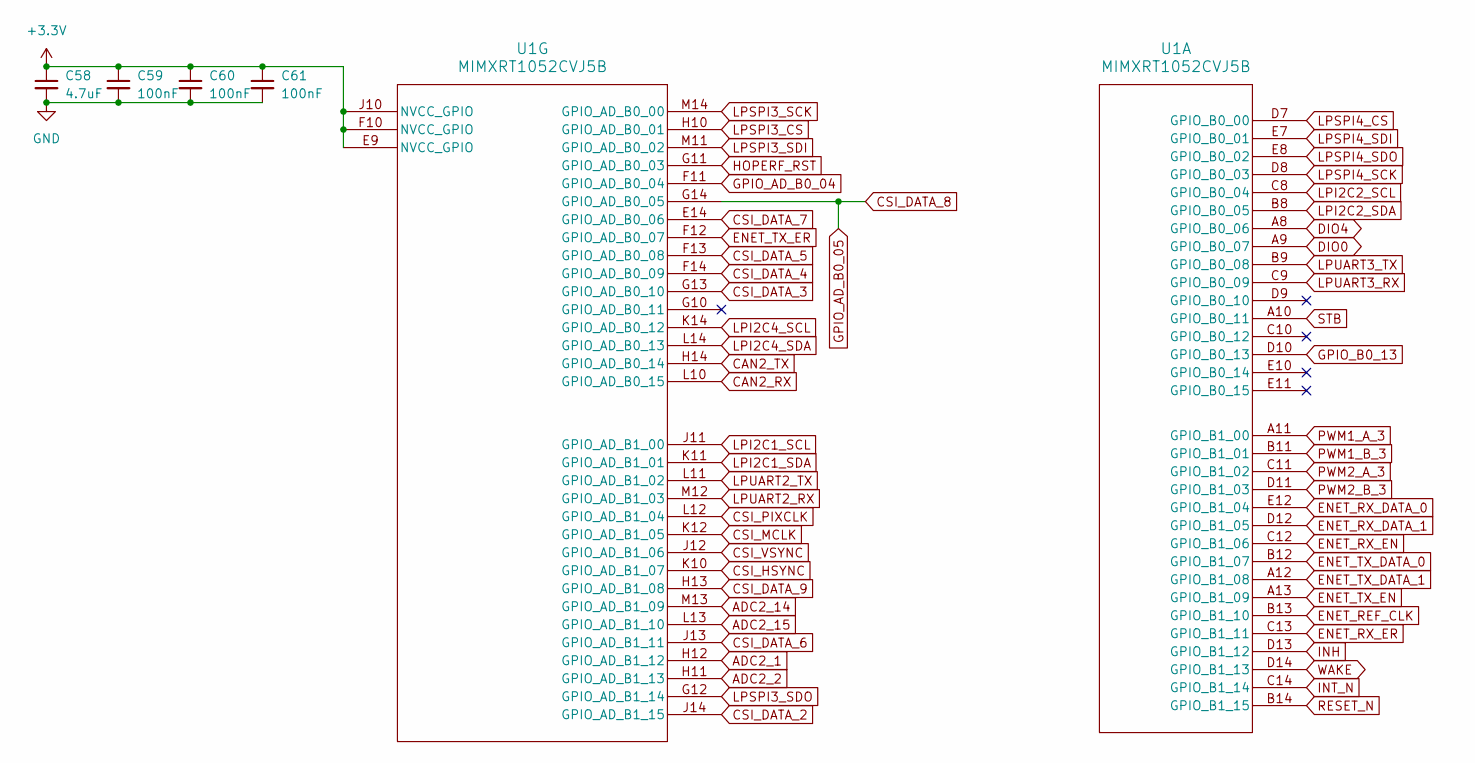
[picture p22: schematic mcu.kicad_sch, RT1050 DevBoard for Project Horizon]

Parts:
C58: 4.7uF; C_0201_0603Metric
C59, C60, C61: 100nF; C_0201_0603Metric
U1: MIMXRT1052CVJ5B; MAPBGA196_12X12

Connections:
+3.3V: C58.1, C59.1, C60.1, C61.1, U1.E9 (NVCC_GPIO), U1.F10 (NVCC_GPIO), U1.J10 (NVCC_GPIO); also elsewhere on the board
ADC2_1: U1.H12 (GPIO_AD_B1_12); also elsewhere on the board
ADC2_2: U1.H11 (GPIO_AD_B1_13); also elsewhere on the board
ADC2_14: U1.M13 (GPIO_AD_B1_09); also elsewhere on the board
ADC2_15: U1.L13 (GPIO_AD_B1_10); also elsewhere on the board
CAN2_RX: U1.L10 (GPIO_AD_B0_15); also elsewhere on the board
CAN2_TX: U1.H14 (GPIO_AD_B0_14); also elsewhere on the board
CSI_DATA_2: U1.J14 (GPIO_AD_B1_15); also elsewhere on the board
CSI_DATA_3: U1.G13 (GPIO_AD_B0_10); also elsewhere on the board
CSI_DATA_4: U1.F14 (GPIO_AD_B0_09); also elsewhere on the board
CSI_DATA_5: U1.F13 (GPIO_AD_B0_08); also elsewhere on the board
CSI_DATA_6: U1.J13 (GPIO_AD_B1_11); also elsewhere on the board
CSI_DATA_7: U1.E14 (GPIO_AD_B0_06); also elsewhere on the board
CSI_DATA_8: U1.G14 (GPIO_AD_B0_05); also elsewhere on the board
CSI_DATA_9: U1.H13 (GPIO_AD_B1_08); also elsewhere on the board
CSI_HSYNC: U1.K10 (GPIO_AD_B1_07); also elsewhere on the board
CSI_MCLK: U1.K12 (GPIO_AD_B1_05); also elsewhere on the board
CSI_PIXCLK: U1.L12 (GPIO_AD_B1_04); also elsewhere on the board
CSI_VSYNC: U1.J12 (GPIO_AD_B1_06); also elsewhere on the board
DIO0: U1.A9 (GPIO_B0_07); also elsewhere on the board
DIO4: U1.A8 (GPIO_B0_06); also elsewhere on the board
ENET_REF_CLK: U1.B13 (GPIO_B1_10); also elsewhere on the board
ENET_RX_DATA_0: U1.E12 (GPIO_B1_04); also elsewhere on the board
ENET_RX_DATA_1: U1.D12 (GPIO_B1_05); also elsewhere on the board
ENET_RX_EN: U1.C12 (GPIO_B1_06); also elsewhere on the board
ENET_RX_ER: U1.C13 (GPIO_B1_11); also elsewhere on the board
ENET_TX_DATA_0: U1.B12 (GPIO_B1_07); also elsewhere on the board
ENET_TX_DATA_1: U1.A12 (GPIO_B1_08); also elsewhere on the board
ENET_TX_EN: U1.A13 (GPIO_B1_09); also elsewhere on the board
ENET_TX_ER: U1.F12 (GPIO_AD_B0_07)
GND: C58.2, C59.2, C60.2, C61.2; also elsewhere on the board
GPIO_AD_B0_04: U1.F11 (GPIO_AD_B0_04); also elsewhere on the board
GPIO_B0_13: U1.D10 (GPIO_B0_13); also elsewhere on the board
HOPERF_RST: U1.G11 (GPIO_AD_B0_03); also elsewhere on the board
INH: U1.D13 (GPIO_B1_12); also elsewhere on the board
INT_N: U1.C14 (GPIO_B1_14); also elsewhere on the board
LPI2C1_SCL: U1.J11 (GPIO_AD_B1_00); also elsewhere on the board
LPI2C1_SDA: U1.K11 (GPIO_AD_B1_01); also elsewhere on the board
LPI2C2_SCL: U1.C8 (GPIO_B0_04); also elsewhere on the board
LPI2C2_SDA: U1.B8 (GPIO_B0_05); also elsewhere on the board
LPI2C4_SCL: U1.K14 (GPIO_AD_B0_12); also elsewhere on the board
LPI2C4_SDA: U1.L14 (GPIO_AD_B0_13); also elsewhere on the board
LPSPI3_CS: U1.H10 (GPIO_AD_B0_01); also elsewhere on the board
LPSPI3_SCK: U1.M14 (GPIO_AD_B0_00); also elsewhere on the board
LPSPI3_SDI: U1.M11 (GPIO_AD_B0_02); also elsewhere on the board
LPSPI3_SDO: U1.G12 (GPIO_AD_B1_14); also elsewhere on the board
LPSPI4_CS: U1.D7 (GPIO_B0_00); also elsewhere on the board
LPSPI4_SCK: U1.D8 (GPIO_B0_03); also elsewhere on the board
LPSPI4_SDI: U1.E7 (GPIO_B0_01); also elsewhere on the board
LPSPI4_SDO: U1.E8 (GPIO_B0_02); also elsewhere on the board
LPUART2_RX: U1.M12 (GPIO_AD_B1_03); also elsewhere on the board
LPUART2_TX: U1.L11 (GPIO_AD_B1_02); also elsewhere on the board
LPUART3_RX: U1.C9 (GPIO_B0_09); also elsewhere on the board
LPUART3_TX: U1.B9 (GPIO_B0_08); also elsewhere on the board
PWM1_A_3: U1.A11 (GPIO_B1_00); also elsewhere on the board
PWM1_B_3: U1.B11 (GPIO_B1_01); also elsewhere on the board
PWM2_A_3: U1.C11 (GPIO_B1_02); also elsewhere on the board
PWM2_B_3: U1.D11 (GPIO_B1_03); also elsewhere on the board
RESET_N: U1.B14 (GPIO_B1_15); also elsewhere on the board
STB: U1.A10 (GPIO_B0_11); also elsewhere on the board
WAKE: U1.D14 (GPIO_B1_13); also elsewhere on the board
