NU-Horizonsat/RT1050-Board/RT1050.kicad_pcb

## KiCad design RT1050.kicad_pcb (continued)

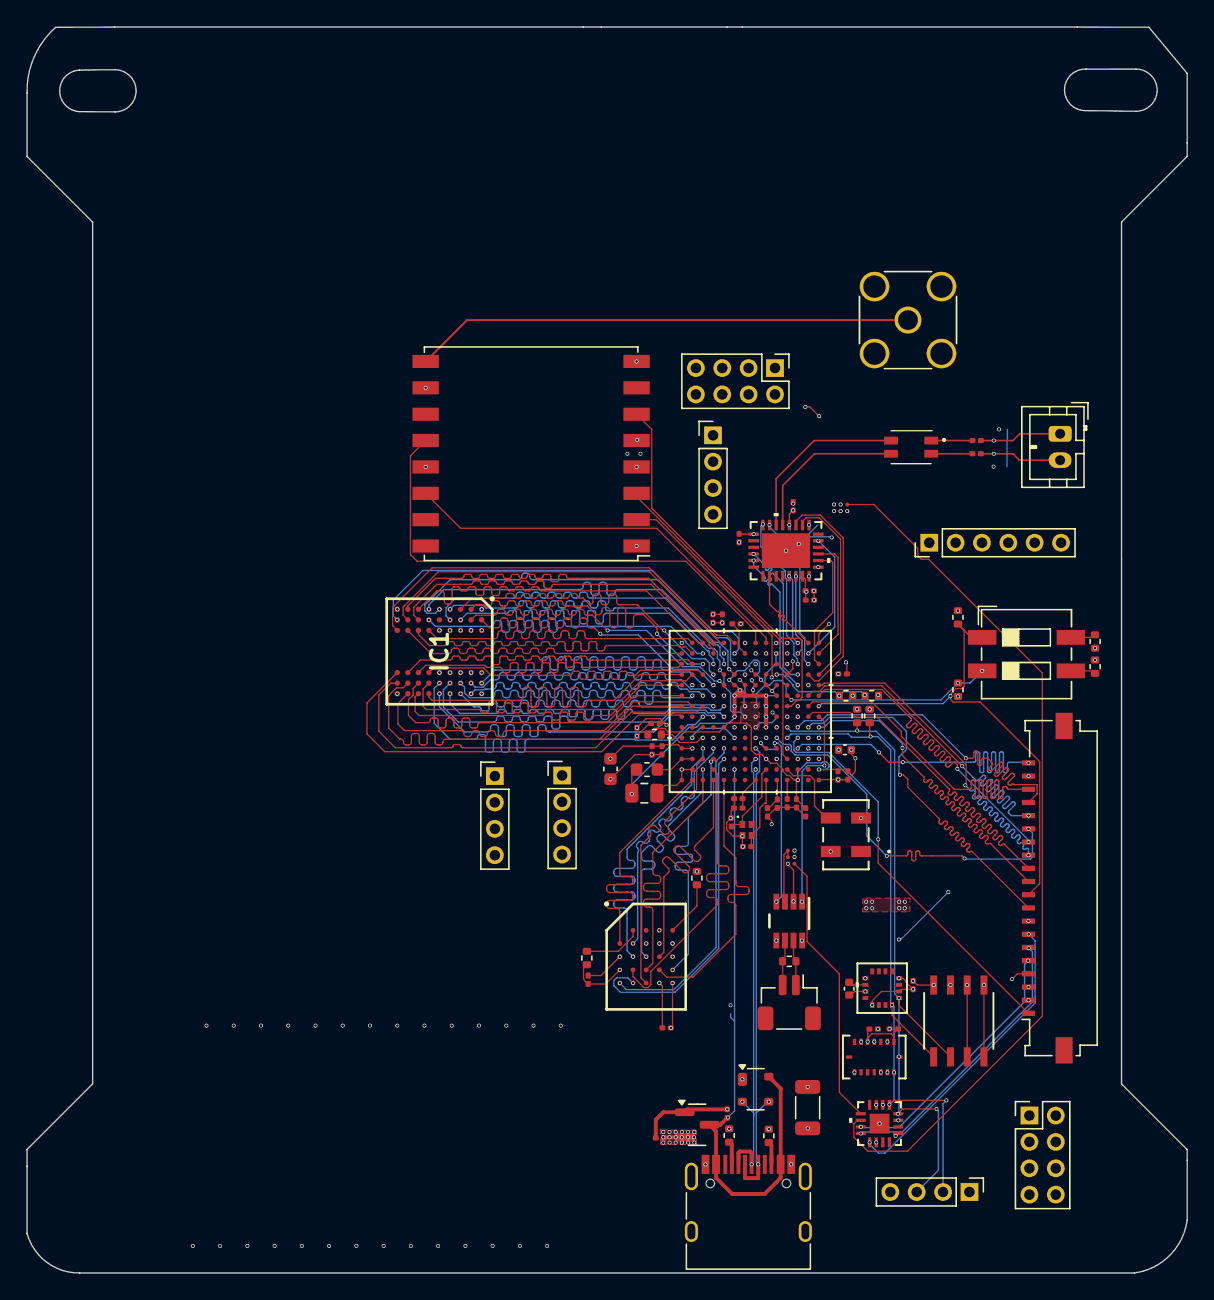
[picture p23: board RT1050.kicad_pcb from above]

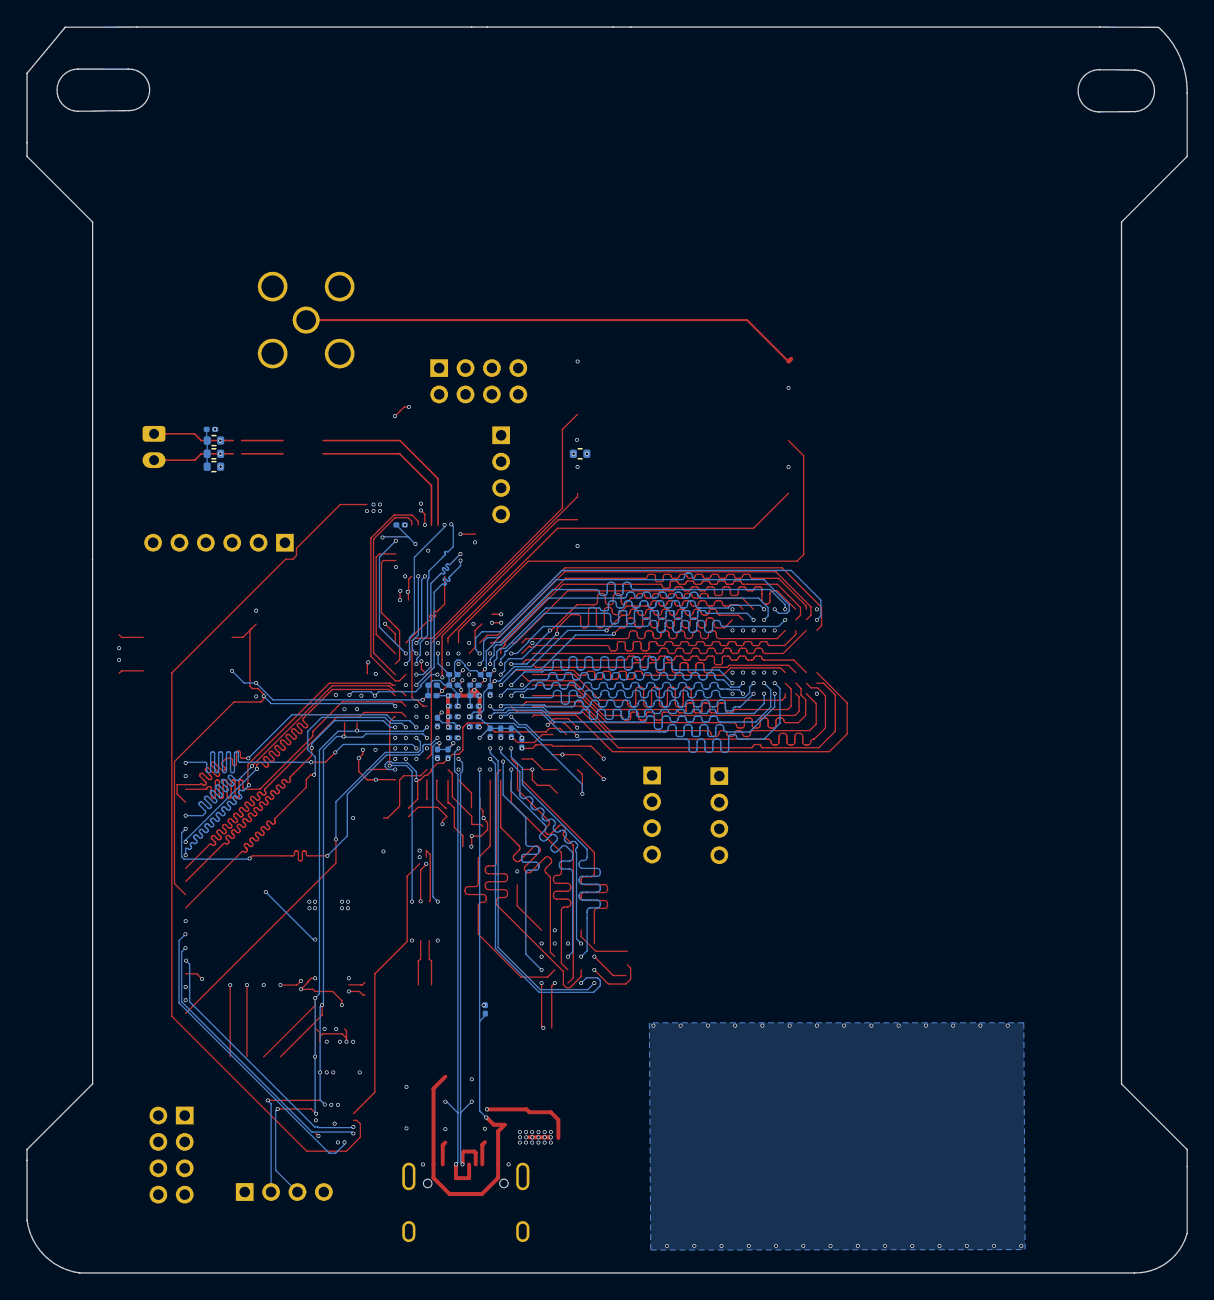
[picture p24: board RT1050.kicad_pcb from below]

Board: 4 copper layers, 88.0 x 94.5 mm, 112 parts (30 on the bottom side), 154 nets.
