NU-Horizonsat/RT1050-Board/(commit log)

2024-10-18 Started RT1050 work
    [RT1050.kicad_pcb, RT1050.kicad_sch, flash.kicad_sch, mcu.kicad_sch, mcu_power.kicad_sch, usb_debug.kicad_sch]
2024-11-06 assign pin functions and started spe
    [RT1050.kicad_sch, csi.kicad_sch, flash.kicad_sch, mcu.kicad_sch, mcu_power.kicad_sch, sensors.kicad_sch, spe.kicad_sch, usb_debug.kicad_sch]
2024-11-12 finished v1
    [RT1050.kicad_sch, can.kicad_sch, connector.kicad_sch, connectors.kicad_sch, csi.kicad_sch, flash.kicad_sch, hoperf.kicad_sch, magnetorguer.kicad_sch]
2024-11-16 added load switches
    [can.kicad_sch, connectors.kicad_sch, csi.kicad_sch, flash.kicad_sch, hoperf.kicad_sch, mcu.kicad_sch, mcu_power.kicad_sch, sensors.kicad_sch]
2024-12-04 save before sdram redesign
    [RT1050.kicad_pcb, can.kicad_sch, connectors.kicad_sch, csi.kicad_sch, flash.kicad_sch, hoperf.kicad_sch, mcu.kicad_sch, mcu_power.kicad_sch]
2024-12-04 quick drc fix before sdram redo
    [RT1050.kicad_pcb]
2024-12-05 SDRAM redo and finished boards
    [RT1050.kicad_pcb]
2024-12-05 added FRAM
    [RT1050.kicad_pcb, sensors.kicad_sch]
2024-12-05 updated schem pdf
    [RT1050.kicad_pcb]
2024-12-05 quick correction
    [RT1050.kicad_sch, can.kicad_sch, connectors.kicad_sch, csi.kicad_sch, flash.kicad_sch, hoperf.kicad_sch, mcu.kicad_sch, mcu_power.kicad_sch]
2024-12-08 cleaned up and dealt with drc
    [RT1050.kicad_pcb, RT1050.kicad_sch, can.kicad_sch, connectors.kicad_sch, csi.kicad_sch, flash.kicad_sch, hoperf.kicad_sch, mcu.kicad_sch]
2024-12-24 quick fix
    [RT1050.kicad_pcb, mcu_power.kicad_sch, sensors.kicad_sch, usb_debug.kicad_sch]
2025-01-03 changes to board due to availability of components
    [RT1050.kicad_pcb, RT1050.step, mcu_power.kicad_sch, spe.kicad_sch]
